alireza1405/medulla/documentation/images/medulla.1.5.JPG

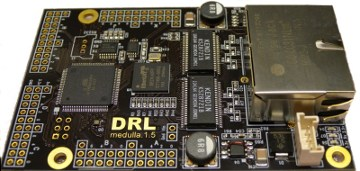
documentation/images/medulla.1.5.JPG
