alireza1405/medulla/hardware/medulla.1.5/CAM-2013/BOM.xls

Ref. Des. | Manufacture | Manufacture # | Description | Digikey # | Quantity
C1,2,3,4,5,6,7,8,9,10,11,12,19,20,21,22,23,24,25,26,27,28,29,30,31,32,35,36,37,38,39,40,41,42,43,44,45,46,47,48,49,50,53,54 | Murata Electronics North America | GRM188R71E104KA01D | CAP CER .1UF 25V 10% X7R | 490-1524-1-ND | 44
C13,14 | AVX Corporation | 0603ZD105KAT2A | CAP CERM 1UF 10% 10V X5R | 478-1251-1-ND | 2
C15,16,17,18 | TDK Corporation | C3225Y5V1E226Z | CAP CER 22UF 25V Y5V | 445-3478-1-ND | 4
C33,34 | Kemet | C0603C180J5GACTU | CAP CERAMIC 18PF 50V NP0 | 399-1052-1-ND | 2
D1 | Vishay/General Semiconductor | SSC53L-E3/57T | DIODE SCHOTTKY 5A 30V | SSC53L-E3/57TGICT-ND | 1
D4,5,6,7 | OSRAM Opto Semiconductors Inc | LG L29K-G2J1-24-Z | LED SMARTLED GREEN 570NM | 475-2709-1-ND | 4
D8,9 | OSRAM Opto Semiconductors Inc | LRTB R98G-R7T5-1+S7U-37+P7R-26 | LED MULTI RGB CHIPLED | 475-2855-1-ND | 2
L1,2 | TDK Corporation | VLP8040T-6R8M | INDUCTOR POWER 6.8UH 3.6A | 445-6586-1-ND | 2
L3,4,5,6,7 | TDK Corporation | MMZ1608R301A | FERRITE CHIP 300 OHM 500MA | 445-2171-1-ND | 5
Q1,2,3,4,5 | ON Semiconductor | NTA7002NT1G | MOSFET N-CH 30V 154MA | NTA7002NT1GOSCT-ND | 5
R1,6,7,8,10,22,23,24,25,26,27,28,29,30,31,32,33,34,35,36,37,38,39,40,41,42,43,44,45,47,48,49,50,51,52 | Rohm Semiconductor | MCR03EZPFX4701 | RES 4.70K OHM 1/10W 1% | RHM4.70KHCT-ND | 35
R12,13,14,15,16,17,18,19 | Rohm Semiconductor | MCR03EZPFX49R9 | RES 49.9 OHM 1/10W 1% | RHM49.9HCT-ND | 8
R2 | Rohm Semiconductor | MCR03EZPFX4020 | RES 402 OHM 1/10W 1% | RHM402HCT-ND | 1
R20,21 | Rohm Semiconductor | MCR03EZPFX64R9 | RES 64.9 OHM 1/10W 1% | RHM64.9HCT-ND | 2
R3,53 | Rohm Semiconductor | MCR03EZPFX8060 | RES 806 OHM 1/10W 1% | RHM806HCT-ND | 2
R4 | Rohm Semiconductor | MCR03EZPFX1651 | RES 1.65K OHM 1/10W 1% | RHM1.65KHCT-ND | 1
R46 | Rohm Semiconductor | MCR03EZPJ102 | RES 1.0K OHM 1/10W 5% | RHM1.0KGCT-ND | 1
R5 | Rohm Semiconductor | MCR03EZPFX1102 | RES 11.0K OHM 1/10W 1% | RHM11.0KHCT-ND | 1
R54,55 | Rohm Semiconductor | MCR03EZPJ430 | RES 43 OHM 1/10W 5% | RHM43GCT-ND | 2
R56 | Rohm Semiconductor | MCR03EZPJ750 | RES 75 OHM 1/10W 5% | RHM75GCT-ND | 1
R57 | Yageo | RC0603FR-0720KL | RES 20.0K OHM 1/10W 1% | 311-20.0KHRCT-ND | 1
R62 | Yageo | RC0603FR-0734KL | RES 34.0K OHM 1/10W 1% | 311-34.0KHRCT-ND | 1
R9,11,58,59,60,61 | Rohm Semiconductor | MCR03EZPFX6491 | RES 6.49K OHM 1/10W 1% | RHM6.49KHCT-ND | 6
S1,2 | C&K Components | KMR221GLFS | SWITCH TACT SPST-NO 200GF GW | 401-1427-1-ND | 2
U1 | Atmel | ATXMEGA128A1-AU | MCU AVR 128K FLASH | ATXMEGA128A1-AU-ND | 1
U2 | Texas Instruments | MAX3221CPWR | DRVR/RCVR RS-232 1-CH | 296-9594-1-ND | 1
U3,4 | Alpha & Omega Semiconductor Inc | AOZ1031AI | IC BUCK SYNC ADJ 3A | 785-1253-1-ND | 2
U5 | Microchip Technology | MCP1700T-2502E/TT | IC REG LDO 250MA 2.5V | MCP1700T-2502E/TTCT-ND | 1
U6,7 | Micrel Inc | KSZ8721B TR | TXRX PHY 10/100 2.5V | 576-1026-1-ND | 2
U8 | Beckhoff | ET1200 | EtherCAT ASIC |  | 1
U9 | Rohm Semiconductor | BR24S16FVT-WE2 | EEPROM 16KBIT 400KHZ | BR24S16FVT-WE2CT-ND | 1
Y1 | TXC Technology Inc | 7M-25.000MAAJ-T | CRYSTAL 25.000 MHZ 18PF | 887-1132-1-ND | 1
