alireza1405/medulla/hardware/medulla.1.5/Documents/BOM-medulla.1.5.ods

Sheet: Sheet BOMs
 | Net Cost | $93.76 | Total Part Count | 125
 | Estimated PCB Cost (50s) | $17.99
 | Estimated Placement Cost (50s) | $17.89
 | For 50 | $4,687.95
Ref. Des. | Manufacture | Manufacture # | Description | Quantity | Price (10sies) | Digikey # | Package | Subtotal | Comments | App. notes
uController
C1,2,3,4,5,6,7,8,9,10,11,12,20,21,22,25,53,54 | Murata Electronics North America | GRM188R71E104KA01D | CAP CER .1UF 25V 10% X7R | 18 | 0.019 | 490-1524-1-ND (http://search.digikey.com/scripts/dksearch/dksus.dll?Detail&name=490-1524-1-ND) | 0603 | 0.34 | Don't order, we have a reel on hand.
L3 | TDK Corporation | MMZ1608R301A | FERRITE CHIP 300 OHM 500MA | 1 | 0.053 | 445-2171-1-ND (http://search.digikey.com/scripts/DkSearch/dksus.dll?Detail&name=445-2171-1-ND) | 0603 | 0.05
 | Molex Connector Corporation | 35362-0350 | CONN HEADER 3POS 2MM VERT | 0 | 0.408 | WM18921-ND (http://search.digikey.com/scripts/dksearch/dksus.dll?Detail&name=WM18921-ND) |  | 0.00
U1 | Atmel | ATXMEGA128A1-AU | MCU AVR 128K FLASH | 1 | 10.200 | ATXMEGA128A1-AU-ND (http://search.digikey.com/scripts/DkSearch/dksus.dll?Detail&name=ATXMEGA128A1-AU-ND) | 100-TQFP | 10.20 | Price for onesies
C13,14 | AVX Corporation | 0603ZD105KAT2A | CAP CERM 1UF 10% 10V X5R | 2 | 0.061 | 478-1251-1-ND (http://search.digikey.com/scripts/DkSearch/dksus.dll?Detail&name=478-1251-1-ND) | 0603 | 0.12
C15,16,17,18 | TDK Corporation | C3225Y5V1E226Z | CAP CER 22UF 25V Y5V | 4 | 0.498 | 445-3478-1-ND (http://search.digikey.com/scripts/dksearch/dksus.dll?Detail&name=445-3478-1-ND) | 1210 | 1.99
D1 | Vishay/General Semiconductor | SSC53L-E3/57T | DIODE SCHOTTKY 5A 30V | 1 | 0.550 | SSC53L-E3/57TGICT-ND (http://search.digikey.com/scripts/dksearch/dksus.dll?Detail&name=SSC53L-E3/57TGICT-ND) | DO-214AB | 0.55
D4,6,7 | OSRAM Opto Semiconductors Inc | LG L29K-G2J1-24-Z | LED SMARTLED GREEN 570NM | 3 | 0.137 | 475-2709-1-ND (http://search.digikey.com/scripts/DkSearch/dksus.dll?Detail&name=475-2709-1-ND) | 0603 | 0.41
D8,9 | OSRAM Opto Semiconductors Inc | LRTB R98G-R7T5-1+S7U-37+P7R-26 | LED MULTI RGB CHIPLED | 2 | 0.860 | 475-2855-1-ND (http://search.digikey.com/scripts/DkSearch/dksus.dll?Detail&name=475-2855-1-ND) |  | 1.72
L1,2 | TDK Corporation | VLP8040T-6R8M | INDUCTOR POWER 6.8UH 3.6A | 2 | 0.524 | 445-6586-1-ND (http://search.digikey.com/scripts/DkSearch/dksus.dll?Detail&name=445-6586-1-ND) |  | 1.05
 | Molex Connector Corporation | 35362-0450 | CONN HEADER 4POS 2MM VERT | 0 | 0.470 | WM18922-ND (http://search.digikey.com/scripts/dksearch/dksus.dll?Detail&name=WM18922-ND) |  | 0.00
Q1,2,3,4,5 | ON Semiconductor | NTA7002NT1G | MOSFET N-CH 30V 154MA | 5 | 0.300 | NTA7002NT1GOSCT-ND (http://search.digikey.com/scripts/dksearch/dksus.dll?Detail&name=NTA7002NT1GOSCT-ND) | SC-75-3 | 1.50
R54,55 | Rohm Semiconductor | MCR03EZPJ430 | RES 43 OHM 1/10W 5% | 2 | 0.018 | RHM43GCT-ND (http://search.digikey.com/scripts/DkSearch/dksus.dll?Detail&name=RHM43GCT-ND) | 0603 | 0.04
R56 | Rohm Semiconductor | MCR03EZPJ750 | RES 75 OHM 1/10W 5% | 1 | 0.018 | RHM75GCT-ND (http://search.digikey.com/scripts/DkSearch/dksus.dll?Detail&name=RHM75GCT-ND) | 0603 | 0.02
R2 | Rohm Semiconductor | MCR03EZPFX4020 | RES 402 OHM 1/10W 1% | 1 | 0.023 | RHM402HCT-ND (http://search.digikey.com/scripts/DkSearch/dksus.dll?Detail&name=RHM402HCT-ND) | 0603 | 0.02
R3 | Rohm Semiconductor | MCR03EZPFX8060 | RES 806 OHM 1/10W 1% | 1 | 0.023 | RHM806HCT-ND (http://search.digikey.com/scripts/DkSearch/dksus.dll?Detail&name=RHM806HCT-ND) | 0603 | 0.02
R4 | Rohm Semiconductor | MCR03EZPFX1651 | RES 1.65K OHM 1/10W 1% | 1 | 0.023 | RHM1.65KHCT-ND (http://search.digikey.com/scripts/DkSearch/dksus.dll?Detail&name=RHM1.65KHCT-ND) | 0603 | 0.02
R1 | Rohm Semiconductor | MCR03EZPFX4701 | RES 4.70K OHM 1/10W 1% | 1 | 0.023 | RHM4.70KHCT-ND (http://search.digikey.com/scripts/DkSearch/dksus.dll?Detail&name=RHM4.70KHCT-ND) | 0603 | 0.02
R58,59,60,61 | Rohm Semiconductor | MCR03EZPFX6491 | RES 6.49K OHM 1/10W 1% | 4 | 0.023 | RHM6.49KHCT-ND (http://search.digikey.com/scripts/DkSearch/dksus.dll?Detail&name=RHM6.49KHCT-ND) | 0603 | 0.09
R57 | Yageo | RC0603FR-0720KL | RES 20.0K OHM 1/10W 1% | 1 | 0.014 | 311-20.0KHRCT-ND (http://search.digikey.com/scripts/DkSearch/dksus.dll?Detail&name=311-20.0KHRCT-ND) | 0603 | 0.01
R62 | Yageo | RC0603FR-0734KL | RES 34.0K OHM 1/10W 1% | 1 | 0.014 | 311-34.0KHRCT-ND (http://search.digikey.com/scripts/DkSearch/dksus.dll?Detail&name=311-34.0KHRCT-ND) | 0603 | 0.01
S1,2 | C&K Components | KMR221GLFS | SWITCH TACT SPST-NO 200GF GW | 2 | 0.370 | 401-1427-1-ND (http://search.digikey.com/scripts/dksearch/dksus.dll?Detail&name=401-1427-1-ND) |  | 0.74
U3,4 | Alpha & Omega Semiconductor Inc | AOZ1031AI | IC BUCK SYNC ADJ 3A | 2 | 1.400 | 785-1253-1-ND (http://search.digikey.com/scripts/DkSearch/dksus.dll?Detail&name=785-1253-1-ND) | SO-8 | 2.80 | Price for onesies
U2 | Texas Instruments | MAX3221CPWR | DRVR/RCVR RS-232 1-CH | 1 | 1.930 | 296-9594-1-ND (http://search.digikey.com/scripts/DkSearch/dksus.dll?Detail&name=296-9594-1-ND) | 16-TSSOP | 1.93 | Price for onesies
U5 | Microchip Technology | MCP1700T-2502E/TT | IC REG LDO 250MA 2.5V | 1 | 0.370 | MCP1700T-2502E/TTCT-ND (http://search.digikey.com/scripts/DkSearch/dksus.dll?Detail&name=MCP1700T-2502E/TTCT-ND) | SOT23-3 | 0.37
Subtotal |  |  |  | 38 |  |  |  | 24.04
EtherCAT
C33,34 | Kemet | C0603C180J5GACTU | CAP CERAMIC 18PF 50V NP0 | 2 | 0.031 | 399-1052-1-ND (http://search.digikey.com/scripts/dksearch/dksus.dll?Detail&name=399-1052-1-ND) | 0603 | 0.06
C19,23,24,26,27,28,29,30,31,32,35,36,37,38,39,40,41,42,43,44,45,46,47,48,49,50 | Murata Electronics North America | GRM188R71E104KA01D | CAP CER .1UF 25V 10% X7R | 26 | 0.019 | 490-1524-1-ND (http://search.digikey.com/scripts/dksearch/dksus.dll?Detail&name=490-1524-1-ND) | 0603 | 0.49 | Don't order, we have a reel on hand.
D5 | OSRAM Opto Semiconductors Inc | LG L29K-G2J1-24-Z | LED SMARTLED GREEN 570NM | 1 | 0.137 | 475-2709-1-ND (http://search.digikey.com/scripts/DkSearch/dksus.dll?Detail&name=475-2709-1-ND) | 0603 | 0.14
 | Pulse | JG0-0031NL | CONN PULSEJACK 2PORT POETHERNET | 0 | 13.006 | 553-1361-ND (http://search.digikey.com/scripts/DkSearch/dksus.dll?Detail&name=553-1361-ND) |  | 0.00
L4,5,6,7 | TDK Corporation | MMZ1608R301A | FERRITE CHIP 300 OHM 500MA | 4 | 0.053 | 445-2171-1-ND (http://search.digikey.com/scripts/DkSearch/dksus.dll?Detail&name=445-2171-1-ND) | 0603 | 0.21
R12,13,14,15,16,17,18,19 | Rohm Semiconductor | MCR03EZPFX49R9 | RES 49.9 OHM 1/10W 1% | 8 | 0.023 | RHM49.9HCT-ND (http://search.digikey.com/scripts/DkSearch/dksus.dll?Detail&name=RHM49.9HCT-ND) | 0603 | 0.18
R20,21 | Rohm Semiconductor | MCR03EZPFX64R9 | RES 64.9 OHM 1/10W 1% | 2 | 0.023 | RHM64.9HCT-ND (http://search.digikey.com/scripts/DkSearch/dksus.dll?Detail&name=RHM64.9HCT-ND) | 0603 | 0.05
R53 | Rohm Semiconductor | MCR03EZPFX8060 | RES 806 OHM 1/10W 1% | 1 | 0.023 | RHM806HCT-ND (http://search.digikey.com/scripts/DkSearch/dksus.dll?Detail&name=RHM806HCT-ND) | 0603 | 0.02
R46 | Rohm Semiconductor | MCR03EZPJ102 | RES 1.0K OHM 1/10W 5% | 1 | 0.018 | RHM1.0KGCT-ND (http://search.digikey.com/scripts/DkSearch/dksus.dll?Detail&name=RHM1.0KGCT-ND) | 0603 | 0.02
R6,7,8,10,22,23,24,25,26,27,28,29,30,31,32,33,34,35,36,37,38,39,40,41,42,43,44,45,47,48,49,50,51,52 | Rohm Semiconductor | MCR03EZPFX4701 | RES 4.70K OHM 1/10W 1% | 34 | 0.023 | RHM4.70KHCT-ND (http://search.digikey.com/scripts/DkSearch/dksus.dll?Detail&name=RHM4.70KHCT-ND) | 0603 | 0.78
R9,11 | Rohm Semiconductor | MCR03EZPFX6491 | RES 6.49K OHM 1/10W 1% | 2 | 0.023 | RHM6.49KHCT-ND (http://search.digikey.com/scripts/DkSearch/dksus.dll?Detail&name=RHM6.49KHCT-ND) | 0603 | 0.05
R5 | Rohm Semiconductor | MCR03EZPFX1102 | RES 11.0K OHM 1/10W 1% | 1 | 0.023 | RHM11.0KHCT-ND (http://search.digikey.com/scripts/DkSearch/dksus.dll?Detail&name=RHM11.0KHCT-ND) | 0603 | 0.02
U8 | Beckhoff | ET1200 | EtherCAT ASIC | 1 | 21.000 |  | BGA | 21.00 | Special order from Beckhoff, price is an estimate
U6,7 | Micrel Inc | KSZ8721B TR | TXRX PHY 10/100 2.5V | 2 | 4.320 | 576-1026-1-ND (http://search.digikey.com/scripts/dksearch/dksus.dll?Detail&name=576-1026-1-ND) | 48SSOP | 8.64 | Price for onesies
U9 | Rohm Semiconductor | BR24S16FVT-WE2 | EEPROM 16KBIT 400KHZ | 1 | 1.03 | BR24S16FVT-WE2CT-ND (http://search.digikey.com/scripts/dksearch/dksus.dll?Detail&name=BR24S16FVT-WE2CT-ND) | 8-TSSOP-B | 1.03 | Price for onesies
Y1 | TXC Technology Inc | 7M-25.000MAAJ-T | CRYSTAL 25.000 MHZ 18PF | 1 | 1.138 | 887-1132-1-ND (http://search.digikey.com/scripts/DkSearch/dksus.dll?Detail&name=887-1132-1-ND) | 3.2mm x 2.5mm | 1.14
Subtotal |  |  |  | 87 |  |  |  | 33.84

Sheet: Full BOM
Ref. Des. | Manufacture | Manufacture # | Description | Digikey # | Quantity | x50 | # Ordered
C1,2,3,4,5,6,7,8,9,10,11,12,19,20,21,22,23,24,25,26,27,28,29,30,31,32,35,36,37,38,39,40,41,42,43,44,45,46,47,48,49,50,53,54 | Murata Electronics North America | GRM188R71E104KA01D | CAP CER .1UF 25V 10% X7R | 490-1524-1-ND | 44 | 2200
C13,14 | AVX Corporation | 0603ZD105KAT2A | CAP CERM 1UF 10% 10V X5R | 478-1251-1-ND | 2 | 100 | 150
C15,16,17,18 | TDK Corporation | C3225Y5V1E226Z | CAP CER 22UF 25V Y5V | 445-3478-1-ND | 4 | 200 | 250
C33,34 | Kemet | C0603C180J5GACTU | CAP CERAMIC 18PF 50V NP0 | 399-1052-1-ND | 2 | 100 | 150
D1 | Vishay/General Semiconductor | SSC53L-E3/57T | DIODE SCHOTTKY 5A 30V | SSC53L-E3/57TGICT-ND | 1 | 50 | 55
D4,5,6,7 | OSRAM Opto Semiconductors Inc | LG L29K-G2J1-24-Z | LED SMARTLED GREEN 570NM | 475-2709-1-ND | 4 | 200 | 250
D8,9 | OSRAM Opto Semiconductors Inc | LRTB R98G-R7T5-1+S7U-37+P7R-26 | LED MULTI RGB CHIPLED | 475-2855-1-ND | 2 | 100 | 110
L1,2 | TDK Corporation | VLP8040T-6R8M | INDUCTOR POWER 6.8UH 3.6A | 445-6586-1-ND | 2 | 100 | 110
L3,4,5,6,7 | TDK Corporation | MMZ1608R301A | FERRITE CHIP 300 OHM 500MA | 445-2171-1-ND | 5 | 250 | 300
Q1,2,3,4,5 | ON Semiconductor | NTA7002NT1G | MOSFET N-CH 30V 154MA | NTA7002NT1GOSCT-ND | 5 | 250 | 275
R1,6,7,8,10,22,23,24,25,26,27,28,29,30,31,32,33,34,35,36,37,38,39,40,41,42,43,44,45,47,48,49,50,51,52 | Rohm Semiconductor | MCR03EZPFX4701 | RES 4.70K OHM 1/10W 1% | RHM4.70KHCT-ND | 35 | 1750 | 2000
R12,13,14,15,16,17,18,19 | Rohm Semiconductor | MCR03EZPFX49R9 | RES 49.9 OHM 1/10W 1% | RHM49.9HCT-ND | 8 | 400 | 500
R2 | Rohm Semiconductor | MCR03EZPFX4020 | RES 402 OHM 1/10W 1% | RHM402HCT-ND | 1 | 50 | 60
R20,21 | Rohm Semiconductor | MCR03EZPFX64R9 | RES 64.9 OHM 1/10W 1% | RHM64.9HCT-ND | 2 | 100 | 120
R3,53 | Rohm Semiconductor | MCR03EZPFX8060 | RES 806 OHM 1/10W 1% | RHM806HCT-ND | 2 | 100 | 120
R4 | Rohm Semiconductor | MCR03EZPFX1651 | RES 1.65K OHM 1/10W 1% | RHM1.65KHCT-ND | 1 | 50 | 60
R46 | Rohm Semiconductor | MCR03EZPJ102 | RES 1.0K OHM 1/10W 5% | RHM1.0KGCT-ND | 1 | 50 | 60
R5 | Rohm Semiconductor | MCR03EZPFX1102 | RES 11.0K OHM 1/10W 1% | RHM11.0KHCT-ND | 1 | 50 | 60
R54,55 | Rohm Semiconductor | MCR03EZPJ430 | RES 43 OHM 1/10W 5% | RHM43GCT-ND | 2 | 100 | 120
R56 | Rohm Semiconductor | MCR03EZPJ750 | RES 75 OHM 1/10W 5% | RHM75GCT-ND | 1 | 50 | 60
R57 | Yageo | RC0603FR-0720KL | RES 20.0K OHM 1/10W 1% | 311-20.0KHRCT-ND | 1 | 50 | 60
R62 | Yageo | RC0603FR-0734KL | RES 34.0K OHM 1/10W 1% | 311-34.0KHRCT-ND | 1 | 50 | 60
R9,11,58,59,60,61 | Rohm Semiconductor | MCR03EZPFX6491 | RES 6.49K OHM 1/10W 1% | RHM6.49KHCT-ND | 6 | 300 | 400
S1,2 | C&K Components | KMR221GLFS | SWITCH TACT SPST-NO 200GF GW | 401-1427-1-ND | 2 | 100 | 110
U1 | Atmel | ATXMEGA128A1-AU | MCU AVR 128K FLASH | ATXMEGA128A1-AU-ND | 1 | 50 | 55
U2 | Texas Instruments | MAX3221CPWR | DRVR/RCVR RS-232 1-CH | 296-9594-1-ND | 1 | 50 | 55
U3,4 | Alpha & Omega Semiconductor Inc | AOZ1031AI | IC BUCK SYNC ADJ 3A | 785-1253-1-ND | 2 | 100 | 110
U5 | Microchip Technology | MCP1700T-2502E/TT | IC REG LDO 250MA 2.5V | MCP1700T-2502E/TTCT-ND | 1 | 50 | 55
U6,7 | Micrel Inc | KSZ8721B TR | TXRX PHY 10/100 2.5V | 576-1026-1-ND | 2 | 100 | 110
U8 | Beckhoff | ET1200 | EtherCAT ASIC |  | 1 | 50
U9 | Rohm Semiconductor | BR24S16FVT-WE2 | EEPROM 16KBIT 400KHZ | BR24S16FVT-WE2CT-ND | 1 | 50 | 55
Y1 | TXC Technology Inc | 7M-25.000MAAJ-T | CRYSTAL 25.000 MHZ 18PF | 887-1132-1-ND | 1 | 50 | 55
