alireza1405/medulla/hardware/medulla.1/Documents/BOM-medulla.1.ods

 | Net Cost | $133.83 | Total Part Count | 113
 | Estimated PCB Cost | 66
 | (In sammaches) | 26.77
Ref. Des. | Manufacture | Manufacture # | Description | Quantity | Price (10sies) | Digikey # | Package | Subtotal | Donation or Sample | Comments | App. notes
uController
C1,2,3,4,5,6,7,8,9,10,11,12,14,20,21,22,25 | Murata Electronics North America | GRM188R71E104KA01D | CAP CER .1UF 25V 10% X7R | 17 | 0.019 | 490-1524-1-ND (http://search.digikey.com/scripts/dksearch/dksus.dll?Detail&name=490-1524-1-ND) | 0603 | 0.32
L3 | TDK Corporation | MMZ1608R301A | FERRITE CHIP 300 OHM 500MA | 1 | 0.053 | 445-2171-1-ND (http://search.digikey.com/scripts/DkSearch/dksus.dll?Detail&name=445-2171-1-ND) | 0603 | 0.05
J3 | Molex Connector Corporation | 35362-0350 | CONN HEADER 3POS 2MM VERT | 1 | 0.408 | WM18921-ND (http://search.digikey.com/scripts/dksearch/dksus.dll?Detail&name=WM18921-ND) |  | 0.41
U1 | Atmel | ATXMEGA128A1-AU | MCU AVR 128K FLASH | 1 | 10.200 | ATXMEGA128A1-AU-ND (http://search.digikey.com/scripts/DkSearch/dksus.dll?Detail&name=ATXMEGA128A1-AU-ND) | 100-TQFP | 10.20 |  | Price for onesies
C13 | Kemet | C0603C225K9PACTU | CAP CERAMIC 2.2UF 6.3V X5R | 1 | 0.121 | 399-3362-1-ND (http://search.digikey.com/scripts/dksearch/dksus.dll?Detail&name=399-3362-1-ND) | 0603 | 0.12
C15,16,17,18 | Murata Electronics North America | GRM21BR61E106KA73L | CAP CER 10UF 25V X5R | 4 | 0.583 | 490-5523-1-ND (http://search.digikey.com/scripts/dksearch/dksus.dll?Detail&name=490-5523-1-ND) | 0805 | 2.33
D1 | Vishay/General Semiconductor | SSC53L-E3/57T | DIODE SCHOTTKY 5A 30V | 1 | 0.550 | SSC53L-E3/57TGICT-ND (http://search.digikey.com/scripts/dksearch/dksus.dll?Detail&name=SSC53L-E3/57TGICT-ND) | DO-214AB | 0.55
D2,3 | Diodes Inc | DFLS230-7 | DIODE SCHOTTKY 2A 30V | 2 | 0.646 | DFLS230DICT-ND (http://search.digikey.com/scripts/dksearch/dksus.dll?Detail&name=DFLS230DICT-ND) | PowerDI™ 123 | 1.29
D4,6,7 | OSRAM Opto Semiconductors Inc | LG L29K-G2J1-24-Z | LED SMARTLED GREEN 570NM | 3 | 0.137 | 475-2709-1-ND (http://search.digikey.com/scripts/DkSearch/dksus.dll?Detail&name=475-2709-1-ND) | 0603 | 0.41
L1,2 | Taiyo Yuden | NR10050T470M | INDUCTOR 47UH 2A 20% | 2 | 1.100 | 587-1700-1-ND (http://search.digikey.com/scripts/dksearch/dksus.dll?Detail&name=587-1700-1-ND) | 10.00mm x 9.80mm x 5.00mm | 2.20
J1 | Molex Connector Corporation | 35362-0450 | CONN HEADER 4POS 2MM VERT | 1 | 0.470 | WM18922-ND (http://search.digikey.com/scripts/dksearch/dksus.dll?Detail&name=WM18922-ND) |  | 0.47
Q1,2 | ON Semiconductor | NTA7002NT1G | MOSFET N-CH 30V 154MA | 2 | 0.270 | NTA7002NT1GOSCT-ND (http://search.digikey.com/scripts/dksearch/dksus.dll?Detail&name=NTA7002NT1GOSCT-ND) | SC-75-3 | 0.54
R2 | Rohm Semiconductor | MCR03EZPFX4020 | RES 402 OHM 1/10W 1% | 1 | 0.077 | RHM402HCT-ND (http://search.digikey.com/scripts/DkSearch/dksus.dll?Detail&name=RHM402HCT-ND) | 0603 | 0.08
R3 | Rohm Semiconductor | MCR03EZPFX8060 | RES 806 OHM 1/10W 1% | 1 | 0.077 | RHM806HCT-ND (http://search.digikey.com/scripts/DkSearch/dksus.dll?Detail&name=RHM806HCT-ND) | 0603 | 0.08
R4 | Rohm Semiconductor | MCR03EZPFX1651 | RES 1.65K OHM 1/10W 1% | 1 | 0.077 | RHM1.65KHCT-ND (http://search.digikey.com/scripts/DkSearch/dksus.dll?Detail&name=RHM1.65KHCT-ND) | 0603 | 0.08
R1 | Rohm Semiconductor | MCR03EZPFX4701 | RES 4.70K OHM 1/10W 1% | 1 | 0.077 | RHM4.70KHCT-ND (http://search.digikey.com/scripts/DkSearch/dksus.dll?Detail&name=RHM4.70KHCT-ND) | 0603 | 0.08
S1 | C&K Components | KMR221GLFS | SWITCH TACT SPST-NO 200GF GW | 1 | 0.370 | 401-1427-1-ND (http://search.digikey.com/scripts/dksearch/dksus.dll?Detail&name=401-1427-1-ND) |  | 0.37
U3 | Diodes Inc | AP1509-50SG-13 | CONV DC-DC 2A 5.0V | 1 | 2.170 | AP1509-50SGDICT-ND (http://search.digikey.com/scripts/dksearch/dksus.dll?Detail&name=AP1509-50SGDICT-ND) | 8-SOIC | 2.17 |  | Price for onesies
U4 | Diodes Inc | AP1509-33SG-13 | CONV DC-DC 2A 3.3V | 1 | 2.170 | AP1509-33SGDICT-ND (http://search.digikey.com/scripts/dksearch/dksus.dll?Detail&name=AP1509-33SGDICT-ND) | 8-SOIC | 2.17 |  | Price for onesies
U2 | Texas Instruments | MAX3221CPWR | DRVR/RCVR RS-232 1-CH | 1 | 1.930 | 296-9594-1-ND (http://search.digikey.com/scripts/DkSearch/dksus.dll?Detail&name=296-9594-1-ND) | 16-TSSOP | 1.93 |  | Price for onesies
U5 | STMicroelectronics | KF25BD-TR | REG VLDO 2.5V INHIB | 1 | 1.479 | 497-7756-1-ND (http://search.digikey.com/scripts/dksearch/dksus.dll?Detail&name=497-7756-1-ND) | 8-SOIC | 1.48 |  | Price for onesies
Subtotal |  |  |  | 25 |  |  |  | 27.33
EtherCAT
C33,34 | Kemet | C0603C180J5GACTU | CAP CERAMIC 18PF 50V NP0 | 2 | 0.031 | 399-1052-1-ND (http://search.digikey.com/scripts/dksearch/dksus.dll?Detail&name=399-1052-1-ND) | 0603 | 0.06
C19,23,24,26,27,28,29,30,31,32,35,36,37,38,39,40,41,42,43,44,45,46,47,48,49,50 | Murata Electronics North America | GRM188R71E104KA01D | CAP CER .1UF 25V 10% X7R | 26 | 0.019 | 490-1524-1-ND (http://search.digikey.com/scripts/dksearch/dksus.dll?Detail&name=490-1524-1-ND) | 0603 | 0.49
D5 | OSRAM Opto Semiconductors Inc | LG L29K-G2J1-24-Z | LED SMARTLED GREEN 570NM | 1 | 0.137 | 475-2709-1-ND (http://search.digikey.com/scripts/DkSearch/dksus.dll?Detail&name=475-2709-1-ND) | 0603 | 0.14
J2 | Pulse | JG0-0031NL | CONN PULSEJACK 2PORT POETHERNET | 1 | 15.110 | 553-1361-ND (http://search.digikey.com/scripts/DkSearch/dksus.dll?Detail&name=553-1361-ND) |  | 15.11 |  | Price for onesies
L4,5,6,7 | TDK Corporation | MMZ1608R301A | FERRITE CHIP 300 OHM 500MA | 4 | 0.053 | 445-2171-1-ND (http://search.digikey.com/scripts/DkSearch/dksus.dll?Detail&name=445-2171-1-ND) | 0603 | 0.21
R12,13,14,15,16,17,18,19 | Rohm Semiconductor | MCR03EZPFX49R9 | RES 49.9 OHM 1/10W 1% | 8 | 0.077 | RHM49.9HCT-ND (http://search.digikey.com/scripts/DkSearch/dksus.dll?Detail&name=RHM49.9HCT-ND) | 0603 | 0.62
R20,21 | Rohm Semiconductor | MCR03EZPFX64R9 | RES 64.9 OHM 1/10W 1% | 2 | 0.077 | RHM64.9HCT-ND (http://search.digikey.com/scripts/DkSearch/dksus.dll?Detail&name=RHM64.9HCT-ND) | 0603 | 0.15
R53 | Rohm Semiconductor | MCR03EZPFX8060 | RES 806 OHM 1/10W 1% | 1 | 0.077 | RHM806HCT-ND (http://search.digikey.com/scripts/DkSearch/dksus.dll?Detail&name=RHM806HCT-ND) | 0603 | 0.08
R6,7,8,10,22,23,24,25,26,27,28,29,30,31,32,33,34,35,36,37,38,39,40,41,42,43,44,45,46,47,48,49,50,51,52 | Rohm Semiconductor | MCR03EZPFX4701 | RES 4.70K OHM 1/10W 1% | 35 | 0.077 | RHM4.70KHCT-ND (http://search.digikey.com/scripts/DkSearch/dksus.dll?Detail&name=RHM4.70KHCT-ND) | 0603 | 2.70
R9,11 | Rohm Semiconductor | MCR03EZPFX6491 | RES 6.49K OHM 1/10W 1% | 2 | 0.077 | RHM6.49KHCT-ND (http://search.digikey.com/scripts/DkSearch/dksus.dll?Detail&name=RHM6.49KHCT-ND) | 0603 | 0.15
R5 | Rohm Semiconductor | MCR03EZPFX1102 | RES 11.0K OHM 1/10W 1% | 1 | 0.077 | RHM11.0KHCT-ND (http://search.digikey.com/scripts/DkSearch/dksus.dll?Detail&name=RHM11.0KHCT-ND) | 0603 | 0.08
U8 | Beckhoff | ET1200 | EtherCAT ASIC | 1 | 10.000 |  |  | 10.00 |  | Special order from Beckhoff, price is an estimate
U6,7 | Micrel Inc | KSZ8721B TR | TXRX PHY 10/100 2.5V | 2 | 4.320 | 576-1026-1-ND (http://search.digikey.com/scripts/dksearch/dksus.dll?Detail&name=576-1026-1-ND) | 48SSOP | 8.64 |  | Price for onesies
U9 | Rohm Semiconductor | BR24S16FVT-WE2 | EEPROM 16KBIT 400KHZ | 1 | 0.940 | BR24S16FVT-WE2CT-ND (http://search.digikey.com/scripts/dksearch/dksus.dll?Detail&name=BR24S16FVT-WE2CT-ND) | 8-TSSOP-B | 0.94 |  | Price for onesies
Y1 | TXC Technology Inc | 7M-25.000MAAJ-T | CRYSTAL 25.000 MHZ 18PF | 1 | 1.138 | 887-1132-1-ND (http://search.digikey.com/scripts/DkSearch/dksus.dll?Detail&name=887-1132-1-ND) | 3.2mm x 2.5mm | 1.14
Subtotal |  |  |  | 88 |  |  |  | 40.51
