alireza1405/medulla/hardware/medulla.0/Documents/BOM-medulla.0.ods

Sheet: Sheet BOMs
 | Net Cost | $225.66 | Total Part Count | 226
 | Estimated PCB Cost | 66
 | (In sammaches) | 45.13
Ref. Des. | Manufacture | Manufacture # | Description | Quantity | Price (10sies) | Digikey # | Package | Subtotal | Donation or Sample | Comments | App. notes
uController
C1,2,3,4,10,11,12,13,25,34,35,36 | Murata Electronics North America | GRM188R71E104KA01D | CAP CER .1UF 25V 10% X7R | 12 | 0.019 | 490-1524-1-ND (http://search.digikey.com/scripts/dksearch/dksus.dll?Detail&name=490-1524-1-ND) | 0603 | 0.23
L1,2 | TDK Corporation | MMZ1608R301A | FERRITE CHIP 300 OHM 500MA | 2 | 0.053 | 445-2171-1-ND (http://search.digikey.com/scripts/DkSearch/dksus.dll?Detail&name=445-2171-1-ND) | 0603 | 0.11
U1,21 | Atmel | ATXMEGA128A3-AU | MCU AVR 128K FLASH | 2 | 8.060 | ATXMEGA128A3-AU-ND (http://search.digikey.com/scripts/dksearch/dksus.dll?Detail&name=ATXMEGA128A3-AU-ND) | 64-TQFP | 16.12 |  | Price for onesies
Subtotal |  |  |  | 16 |  |  |  | 16.45
EtherCAT
C52,80 | Kemet | C0603C180J5GACTU | CAP CERAMIC 18PF 50V NP0 | 2 | 0.031 | 399-1052-1-ND (http://search.digikey.com/scripts/dksearch/dksus.dll?Detail&name=399-1052-1-ND) | 0603 | 0.06
C37,39,40,45,46,47,48,49,50,51,53,54,55,56,57,58,59,60,61,62,63,66,67,68,73,82 | Murata Electronics North America | GRM188R71E104KA01D | CAP CER .1UF 25V 10% X7R | 26 | 0.019 | 490-1524-1-ND (http://search.digikey.com/scripts/dksearch/dksus.dll?Detail&name=490-1524-1-ND) | 0603 | 0.49
D5 | OSRAM Opto Semiconductors Inc | LG L29K-G2J1-24-Z | LED SMARTLED GREEN 570NM | 1 | 0.137 | 475-2709-1-ND (http://search.digikey.com/scripts/DkSearch/dksus.dll?Detail&name=475-2709-1-ND) | 0603 | 0.14
J2 | Pulse | JG0-0031NL | CONN PULSEJACK 2PORT POETHERNET | 1 | 13.150 | 553-1361-ND (http://search.digikey.com/scripts/DkSearch/dksus.dll?Detail&name=553-1361-ND) |  | 13.15 |  | Price for onesies
L5,6,7,8 | TDK Corporation | MMZ1608R301A | FERRITE CHIP 300 OHM 500MA | 4 | 0.053 | 445-2171-1-ND (http://search.digikey.com/scripts/DkSearch/dksus.dll?Detail&name=445-2171-1-ND) | 0603 | 0.21
R66,67,68,69,82,83,84,85 | Rohm Semiconductor | MCR03EZPFX49R9 | RES 49.9 OHM 1/10W 1% | 8 | 0.077 | RHM49.9HCT-ND (http://search.digikey.com/scripts/DkSearch/dksus.dll?Detail&name=RHM49.9HCT-ND) | 0603 | 0.62
R70,71 | Rohm Semiconductor | MCR03EZPFX64R9 | RES 64.9 OHM 1/10W 1% | 2 | 0.077 | RHM64.9HCT-ND (http://search.digikey.com/scripts/DkSearch/dksus.dll?Detail&name=RHM64.9HCT-ND) | 0603 | 0.15
R75 | Rohm Semiconductor | MCR03EZPFX8060 | RES 806 OHM 1/10W 1% | 1 | 0.077 | RHM806HCT-ND (http://search.digikey.com/scripts/DkSearch/dksus.dll?Detail&name=RHM806HCT-ND) | 0603 | 0.08
R37,38,39,40,41,42,43,44,45,46,48,49,50,51,52,53,54,55,56,57,58,59,60,61,62,63,64,65,72,73,74,76,77,80,81 | Rohm Semiconductor | MCR03EZPFX4701 | RES 4.70K OHM 1/10W 1% | 35 | 0.077 | RHM4.70KHCT-ND (http://search.digikey.com/scripts/DkSearch/dksus.dll?Detail&name=RHM4.70KHCT-ND) | 0603 | 2.70
R36,47 | Rohm Semiconductor | MCR03EZPFX6491 | RES 6.49K OHM 1/10W 1% | 2 | 0.077 | RHM6.49KHCT-ND (http://search.digikey.com/scripts/DkSearch/dksus.dll?Detail&name=RHM6.49KHCT-ND) | 0603 | 0.15
R78 | Rohm Semiconductor | MCR03EZPFX1102 | RES 11.0K OHM 1/10W 1% | 1 | 0.077 | RHM11.0KHCT-ND (http://search.digikey.com/scripts/DkSearch/dksus.dll?Detail&name=RHM11.0KHCT-ND) | 0603 | 0.08
U28 | Beckhoff | ET1200 | EtherCAT ASIC | 1 | 10.000 |  |  | 10.00 |  | Special order from Beckhoff, price is an estimate
U19,20 | Micrel Inc | KSZ8721B TR | TXRX PHY 10/100 2.5V | 2 | 4.320 | 576-1026-1-ND (http://search.digikey.com/scripts/dksearch/dksus.dll?Detail&name=576-1026-1-ND) | 48SSOP | 8.64 |  | Price for onesies
U27 | Rohm Semiconductor | BR24S16FVT-WE2 | EEPROM 16KBIT 400KHZ | 1 | 0.940 | BR24S16FVT-WE2CT-ND (http://search.digikey.com/scripts/dksearch/dksus.dll?Detail&name=BR24S16FVT-WE2CT-ND) | 8-TSSOP-B | 0.94 |  | Price for onesies
Y2 | TXC Technology Inc | 7M-25.000MAAJ-T | CRYSTAL 25.000 MHZ 18PF | 1 | 1.138 | 887-1132-1-ND (http://search.digikey.com/scripts/DkSearch/dksus.dll?Detail&name=887-1132-1-ND) | 3.2mm x 2.5mm | 1.14
Subtotal |  |  |  | 88 |  |  |  | 38.55
Power/Reset
C65,84 | Murata Electronics North America | GRM188R71E104KA01D | CAP CER .1UF 25V 10% X7R | 2 | 0.019 | 490-1524-1-ND (http://search.digikey.com/scripts/dksearch/dksus.dll?Detail&name=490-1524-1-ND) | 0603 | 0.04
C64 | Kemet | C0603C225K9PACTU | CAP CERAMIC 2.2UF 6.3V X5R | 1 | 0.121 | 399-3362-1-ND (http://search.digikey.com/scripts/dksearch/dksus.dll?Detail&name=399-3362-1-ND) | 0603 | 0.12
C41,42,43,44 | Taiyo Yuden | TMK316BJ106KL-T | CAP CER 10UF 25V X5R | 4 | 0.583 | 587-1337-1-ND (http://search.digikey.com/scripts/dksearch/dksus.dll?Detail&name=587-1337-1-ND) | 1206 | 2.33
D1,2,7 | Vishay/General Semiconductor | SSC53L-E3/57T | DIODE SCHOTTKY 5A 30V | 3 | 0.550 | SSC53L-E3/57TGICT-ND (http://search.digikey.com/scripts/dksearch/dksus.dll?Detail&name=SSC53L-E3/57TGICT-ND) | DO-214AB | 1.65
D3,4,6 | OSRAM Opto Semiconductors Inc | LG L29K-G2J1-24-Z | LED SMARTLED GREEN 570NM | 3 | 0.137 | 475-2709-1-ND (http://search.digikey.com/scripts/DkSearch/dksus.dll?Detail&name=475-2709-1-ND) | 0603 | 0.41
L3,4 | Taiyo Yuden | NR10050T470M | INDUCTOR 47UH 2A 20% | 2 | 1.100 | 587-1700-1-ND (http://search.digikey.com/scripts/dksearch/dksus.dll?Detail&name=587-1700-1-ND) | 10.00mm x 9.80mm x 5.00mm | 2.20
J80 | Molex Connector Corporation | 35362-0450 | CONN HEADER 4POS 2MM VERT | 1 | 0.470 | WM18922-ND (http://search.digikey.com/scripts/dksearch/dksus.dll?Detail&name=WM18922-ND) |  | 0.47
Q13,14,15 | ON Semiconductor | NTA7002NT1G | MOSFET N-CH 30V 154MA | 3 | 0.270 | NTA7002NT1GOSCT-ND (http://search.digikey.com/scripts/dksearch/dksus.dll?Detail&name=NTA7002NT1GOSCT-ND) | SC-75-3 | 0.81
R79 | Rohm Semiconductor | MCR03EZPFX4020 | RES 402 OHM 1/10W 1% | 1 | 0.077 | RHM402HCT-ND (http://search.digikey.com/scripts/DkSearch/dksus.dll?Detail&name=RHM402HCT-ND) | 0603 | 0.08
R1 | Rohm Semiconductor | MCR03EZPFX8060 | RES 806 OHM 1/10W 1% | 1 | 0.077 | RHM806HCT-ND (http://search.digikey.com/scripts/DkSearch/dksus.dll?Detail&name=RHM806HCT-ND) | 0603 | 0.08
R2 | Rohm Semiconductor | MCR03EZPFX1651 | RES 1.65K OHM 1/10W 1% | 1 | 0.077 | RHM1.65KHCT-ND (http://search.digikey.com/scripts/DkSearch/dksus.dll?Detail&name=RHM1.65KHCT-ND) | 0603 | 0.08
R88 | Rohm Semiconductor | MCR03EZPFX4701 | RES 4.70K OHM 1/10W 1% | 1 | 0.077 | RHM4.70KHCT-ND (http://search.digikey.com/scripts/DkSearch/dksus.dll?Detail&name=RHM4.70KHCT-ND) | 0603 | 0.08
S1 | C&K Components | KMR221GLFS | SWITCH TACT SPST-NO 200GF GW | 1 | 0.450 | 401-1427-1-ND (http://search.digikey.com/scripts/dksearch/dksus.dll?Detail&name=401-1427-1-ND) |  | 0.45
U26 | Diodes Inc | AP1509-50SG-13 | CONV DC-DC 2A 5.0V | 1 | 2.600 | AP1509-50SGDICT-ND (http://search.digikey.com/scripts/dksearch/dksus.dll?Detail&name=AP1509-50SGDICT-ND) | 8-SOIC | 2.60 |  | Price for onesies
U17 | Diodes Inc | AP1509-33SG-13 | CONV DC-DC 2A 3.3V | 1 | 2.600 | AP1509-33SGDICT-ND (http://search.digikey.com/scripts/dksearch/dksus.dll?Detail&name=AP1509-33SGDICT-ND) | 8-SOIC | 2.60 |  | Price for onesies
U29 | STMicroelectronics | KF25BD-TR | REG VLDO 2.5V INHIB | 1 | 1.370 | 497-7756-1-ND (http://search.digikey.com/scripts/dksearch/dksus.dll?Detail&name=497-7756-1-ND) | 8-SOIC | 1.37 |  | Price for onesies
Subtotal |  |  |  | 27 |  |  |  | 15.36
Transceivers/Inputs
C5,6,7,8,9,14,16,17,15,18,19,20,21,22,26,27,28,29,30,31,32,33,38,39,40 | Murata Electronics North America | GRM188R71E104KA01D | CAP CER .1UF 25V 10% X7R | 25 | 0.019 | 490-1524-1-ND (http://search.digikey.com/scripts/dksearch/dksus.dll?Detail&name=490-1524-1-ND) | 0603 | 0.48
J12,14,16,18,20,22,24,26,28,30,32,34 | Molex Connector Corporation | 35362-0250 | CONN HEADER 2POS 2MM VERT | 12 | 0.333 | WM18920-ND (http://search.digikey.com/scripts/dksearch/dksus.dll?Detail&name=WM18920-ND) |  | 4.00
J27,29,31 | Molex Connector Corporation | 35362-0350 | CONN HEADER 3POS 2MM VERT | 3 | 0.408 | WM18921-ND (http://search.digikey.com/scripts/dksearch/dksus.dll?Detail&name=WM18921-ND) |  | 1.22
J61,62,64,65,66,67 | Molex Connector Corporation | 35362-0450 | CONN HEADER 4POS 2MM VERT | 6 | 0.470 | WM18922-ND (http://search.digikey.com/scripts/dksearch/dksus.dll?Detail&name=WM18922-ND) |  | 2.82
J37,39,41,43,45,47,49,51,53,55,57,59 | Molex Connector Corporation | 35362-0650 | CONN HEADER 6POS 2MM VERT | 12 | 0.626 | WM18924-ND (http://search.digikey.com/scripts/dksearch/dksus.dll?Detail&name=WM18924-ND) |  | 7.51
J3,5,7,9 | Molex Connector Corporation | 35362-0850 | CONN HEADER 8POS 2MM VERT | 4 | 0.816 | WM18926-ND (http://search.digikey.com/scripts/dksearch/dksus.dll?Detail&name=WM18926-ND) |  | 3.26
Q1,2,3,4,5,6,7,8,9 | ON Semiconductor | NTA7002NT1G | MOSFET N-CH 30V 154MA | 9 | 0.270 | NTA7002NT1GOSCT-ND (http://search.digikey.com/scripts/dksearch/dksus.dll?Detail&name=NTA7002NT1GOSCT-ND) | SC-75-3 | 2.43
R3,4,5 | Rohm Semiconductor | MCR03EZPFX4701 | RES 4.70K OHM 1/10W 1% | 3 | 0.077 | RHM4.70KHCT-ND (http://search.digikey.com/scripts/DkSearch/dksus.dll?Detail&name=RHM4.70KHCT-ND) | 0603 | 0.23
U2 | Texas Instruments | MAX3221CPWR | DRVR/RCVR RS-232 1-CH | 1 | 1.930 | 296-9594-1-ND (http://search.digikey.com/scripts/DkSearch/dksus.dll?Detail&name=296-9594-1-ND) | 16-TSSOP | 1.93 |  | Price for onesies
U3,4,5,6 | Analog Devices Inc | ADM3490ARZ | TXRX RS-422/485 3.3V | 4 | 2.390 | ADM3490ARZ-ND (http://search.digikey.com/scripts/DkSearch/dksus.dll?Detail&name=ADM3490ARZ-ND) | 8-SOIC | 9.56 |  | Price for onesies
U7,8 | Texas Instruments | AM26LV32CD | QUAD DIFF LINE RCVR | 2 | 1.540 | 296-6794-5-ND (http://search.digikey.com/scripts/dksearch/dksus.dll?Detail&name=296-6794-5-ND) | 16-SOIC | 3.08 |  | Price for onesies
U11,12 | Texas Instruments | AM26LV31EIDR | DRIVER DIFF QUAD LV HS | 2 | 1.750 | 296-24690-1-ND (http://search.digikey.com/scripts/dksearch/dksus.dll?Detail&name=296-24690-1-ND) | 16-SOIC | 3.50 |  | Price for onesies
U22,23,24 | Texas Instruments | INA2321EA/250 | OPAMP INSTR R-R DUAL | 3 | 5.850 | INA2321EACT-ND (http://search.digikey.com/scripts/DkSearch/dksus.dll?Detail&name=INA2321EACT-ND) | 14-TSSOP | 17.55 |  | Price for onesies
U15,16,30 | Texas Instruments | SN74LVC245ADWR | BUS TRANSCEIVER 8BIT | 3 | 0.550 | 296-1232-1-ND (http://search.digikey.com/scripts/dksearch/dksus.dll?Detail&name=296-1232-1-ND) | 20-SOIC (7.5mm Width) | 1.65
U9,10,18 | Texas Instruments | AM26LS32ACDR | QUAD DIFF LINE RCVR | 3 | 0.950 | 296-1011-1-ND (http://search.digikey.com/scripts/DkSearch/dksus.dll?Detail&name=296-1011-1-ND) | 16-SOIC | 2.85 |  | Price for onesies
U13,14 | Avago Technologies US Inc. | HCTL-2032-SC | DECODER/COUNTER 32BIT | 2 | 11.250 | 516-1885-5-ND | 32-SOIC | 22.50
Y1 | ECS Inc | ECS-3951M-330-B-TR | OSC 33.000 MHZ 5.0V | 1 | 4.725 | XC785CT-ND (http://search.digikey.com/scripts/dksearch/dksus.dll?Detail&name=XC785CT-ND) | 7.50mm x 5.00mm | 4.73
Subtotal |  |  |  | 95 |  |  |  | 89.30

Sheet: Total BOM
Ref. Des. | Manufacture | Manufacture # | Description | Digikey # | Quantity | 5x Quantity | # Ordered | In Hand
C1,2,3,4,5,6,7,8,9,10,11,12,13,14,15,16,17,18,19,20,21,22,25,26,27,28,29,30,31,32,33,34,35,36,37,38,39,39,40,40,45,46,47,48,49,50,51,53,54,55,56,57,58,59,60,61,62,63,65,66,67,68,73,82,84 | Murata Electronics North America | GRM188R71E104KA01D | CAP CER .1UF 25V 10% X7R | 490-1524-1-ND | 65 | 325 | 500 | 500
C41,42,43,44 | Taiyo Yuden | TMK316BJ106KL-T | CAP CER 10UF 25V X5R | 587-1337-1-ND | 4 | 20 | 30
C52,80 | Kemet | C0603C180J5GACTU | CAP CERAMIC 18PF 50V NP0 | 399-1052-1-ND | 2 | 10 | 20
C64 | Kemet | C0603C225K9PACTU | CAP CERAMIC 2.2UF 6.3V X5R | 399-3362-1-ND | 1 | 5 | 10
D1,2,7 | Vishay/General Semiconductor | SSC53L-E3/57T | DIODE SCHOTTKY 5A 30V | SSC53L-E3/57TGICT-ND | 3 | 15 | 18 | 18
D3,4,5,6 | OSRAM Opto Semiconductors Inc | LG L29K-G2J1-24-Z | LED SMARTLED GREEN 570NM | 475-2709-1-ND | 4 | 20 | 25
J12,14,16,18,20,22,24,26,28,30,32,34 | Molex Connector Corporation | 35362-0250 | CONN HEADER 2POS 2MM VERT | WM18920-ND | 12 | 60 | 65
J2 | Pulse | JG0-0031NL | CONN PULSEJACK 2PORT POETHERNET | 553-1361-ND | 1 | 5 | 5 | 5
J27,29,31 | Molex Connector Corporation | 35362-0350 | CONN HEADER 3POS 2MM VERT | WM18921-ND | 3 | 15 | 20 | 20
J3,5,7,9 | Molex Connector Corporation | 35362-0850 | CONN HEADER 8POS 2MM VERT | WM18926-ND | 4 | 20 | 25 | 25
J37,39,41,43,45,47,49,51,53,55,57,59 | Molex Connector Corporation | 35362-0650 | CONN HEADER 6POS 2MM VERT | WM18924-ND | 12 | 60 | 65 | 65
J61,62,64,65,66,67,80 | Molex Connector Corporation | 35362-0450 | CONN HEADER 4POS 2MM VERT | WM18922-ND | 7 | 35 | 40
L1,2,5,6,7,8 | TDK Corporation | MMZ1608R301A | FERRITE CHIP 300 OHM 500MA | 445-2171-1-ND | 6 | 30 | 40
L3,4 | Taiyo Yuden | NR10050T470M | INDUCTOR 47UH 2A 20% | 587-1700-1-ND | 2 | 10 | 10 | 10
Q1,2,3,4,5,6,7,8,9,13,14,15 | ON Semiconductor | NTA7002NT1G | MOSFET N-CH 30V 154MA | NTA7002NT1GOSCT-ND | 12 | 60 | 65
R1,75 | Rohm Semiconductor | MCR03EZPFX8060 | RES 806 OHM 1/10W 1% | RHM806HCT-ND | 2 | 10 | 20
R2 | Rohm Semiconductor | MCR03EZPFX1651 | RES 1.65K OHM 1/10W 1% | RHM1.65KHCT-ND | 1 | 5 | 10
R3,4,5,37,38,39,40,41,42,43,44,45,46,48,49,50,51,52,53,54,55,56,57,58,59,60,61,62,63,64,65,72,73,74,76,77,80,81,88 | Rohm Semiconductor | MCR03EZPFX4701 | RES 4.70K OHM 1/10W 1% | RHM4.70KHCT-ND | 39 | 195 | 210
R36,47 | Rohm Semiconductor | MCR03EZPFX6491 | RES 6.49K OHM 1/10W 1% | RHM6.49KHCT-ND | 2 | 10 | 20
R66,67,68,69,82,83,84,85 | Rohm Semiconductor | MCR03EZPFX49R9 | RES 49.9 OHM 1/10W 1% | RHM49.9HCT-ND | 8 | 40 | 50
R70,71 | Rohm Semiconductor | MCR03EZPFX64R9 | RES 64.9 OHM 1/10W 1% | RHM64.9HCT-ND | 2 | 10 | 20
R78 | Rohm Semiconductor | MCR03EZPFX1102 | RES 11.0K OHM 1/10W 1% | RHM11.0KHCT-ND | 1 | 5 | 10
R79 | Rohm Semiconductor | MCR03EZPFX4020 | RES 402 OHM 1/10W 1% | RHM402HCT-ND | 1 | 5 | 10 | 10
S1 | C&K Components | KMR221GLFS | SWITCH TACT SPST-NO 200GF GW | 401-1427-1-ND | 1 | 5 | 7
U1,21 | Atmel | ATXMEGA128A3-AU | MCU AVR 128K FLASH | ATXMEGA128A3-AU-ND | 2 | 10 | 10
U11,12 | Texas Instruments | AM26LV31EIDR | DRIVER DIFF QUAD LV HS | 296-24690-1-ND | 2 | 10 | 11
U13,14 | Avago Technologies US Inc. | HCTL-2032-SC | DECODER/COUNTER 32BIT | 516-1885-5-ND | 2 | 10 | 10 | 10
U15,16,30 | Texas Instruments | SN74LVC245ADWR | BUS TRANSCEIVER 8BIT | 296-1232-1-ND | 3 | 15 | 16
U17 | Diodes Inc | AP1509-33SG-13 | CONV DC-DC 2A 3.3V | AP1509-33SGDICT-ND | 1 | 5 | 6 | 6
U19,20 | Micrel Inc | KSZ8721B TR | TXRX PHY 10/100 2.5V | 576-1026-1-ND | 2 | 10 | 10 | 10
U2 | Texas Instruments | MAX3221CPWR | DRVR/RCVR RS-232 1-CH | 296-9594-1-ND | 1 | 5 | 6
U22,23,24 | Texas Instruments | INA2321EA/250 | OPAMP INSTR R-R DUAL | INA2321EACT-ND | 3 | 15 | 15
U26 | Diodes Inc | AP1509-50SG-13 | CONV DC-DC 2A 5.0V | AP1509-50SGDICT-ND | 1 | 5 | 6
U27 | Rohm Semiconductor | BR24S16FVT-WE2 | EEPROM 16KBIT 400KHZ | BR24S16FVT-WE2CT-ND | 1 | 5 | 6
U28 | Beckhoff | ET1200 | EtherCAT ASIC |  | 1 | 5
U29 | STMicroelectronics | KF25BD-TR | REG VLDO 2.5V INHIB | 497-7756-1-ND | 1 | 5 | 6
U3,4,5,6 | Analog Devices Inc | ADM3490ARZ | TXRX RS-422/485 3.3V | ADM3490ARZ-ND | 4 | 20 | 21 | 21
U7,8 | Texas Instruments | AM26LV32CD | QUAD DIFF LINE RCVR | 296-6794-5-ND | 2 | 10 | 11
U9,10,18 | Texas Instruments | AM26LS32ACDR | QUAD DIFF LINE RCVR | 296-1011-1-ND | 3 | 15 | 16
Y1 | ECS Inc | ECS-3951M-330-B-TR | OSC 33.000 MHZ 5.0V | XC785CT-ND | 1 | 5 | 5
Y2 | TXC Technology Inc | 7M-25.000MAAJ-T | CRYSTAL 25.000 MHZ 18PF | 887-1132-1-ND | 1 | 5 | 5
