alireza1405/medulla/hardware/medulla.1/Schematic/medulla.1.pdf

6 | 5 | 4 | 3 | 2 | 1

D

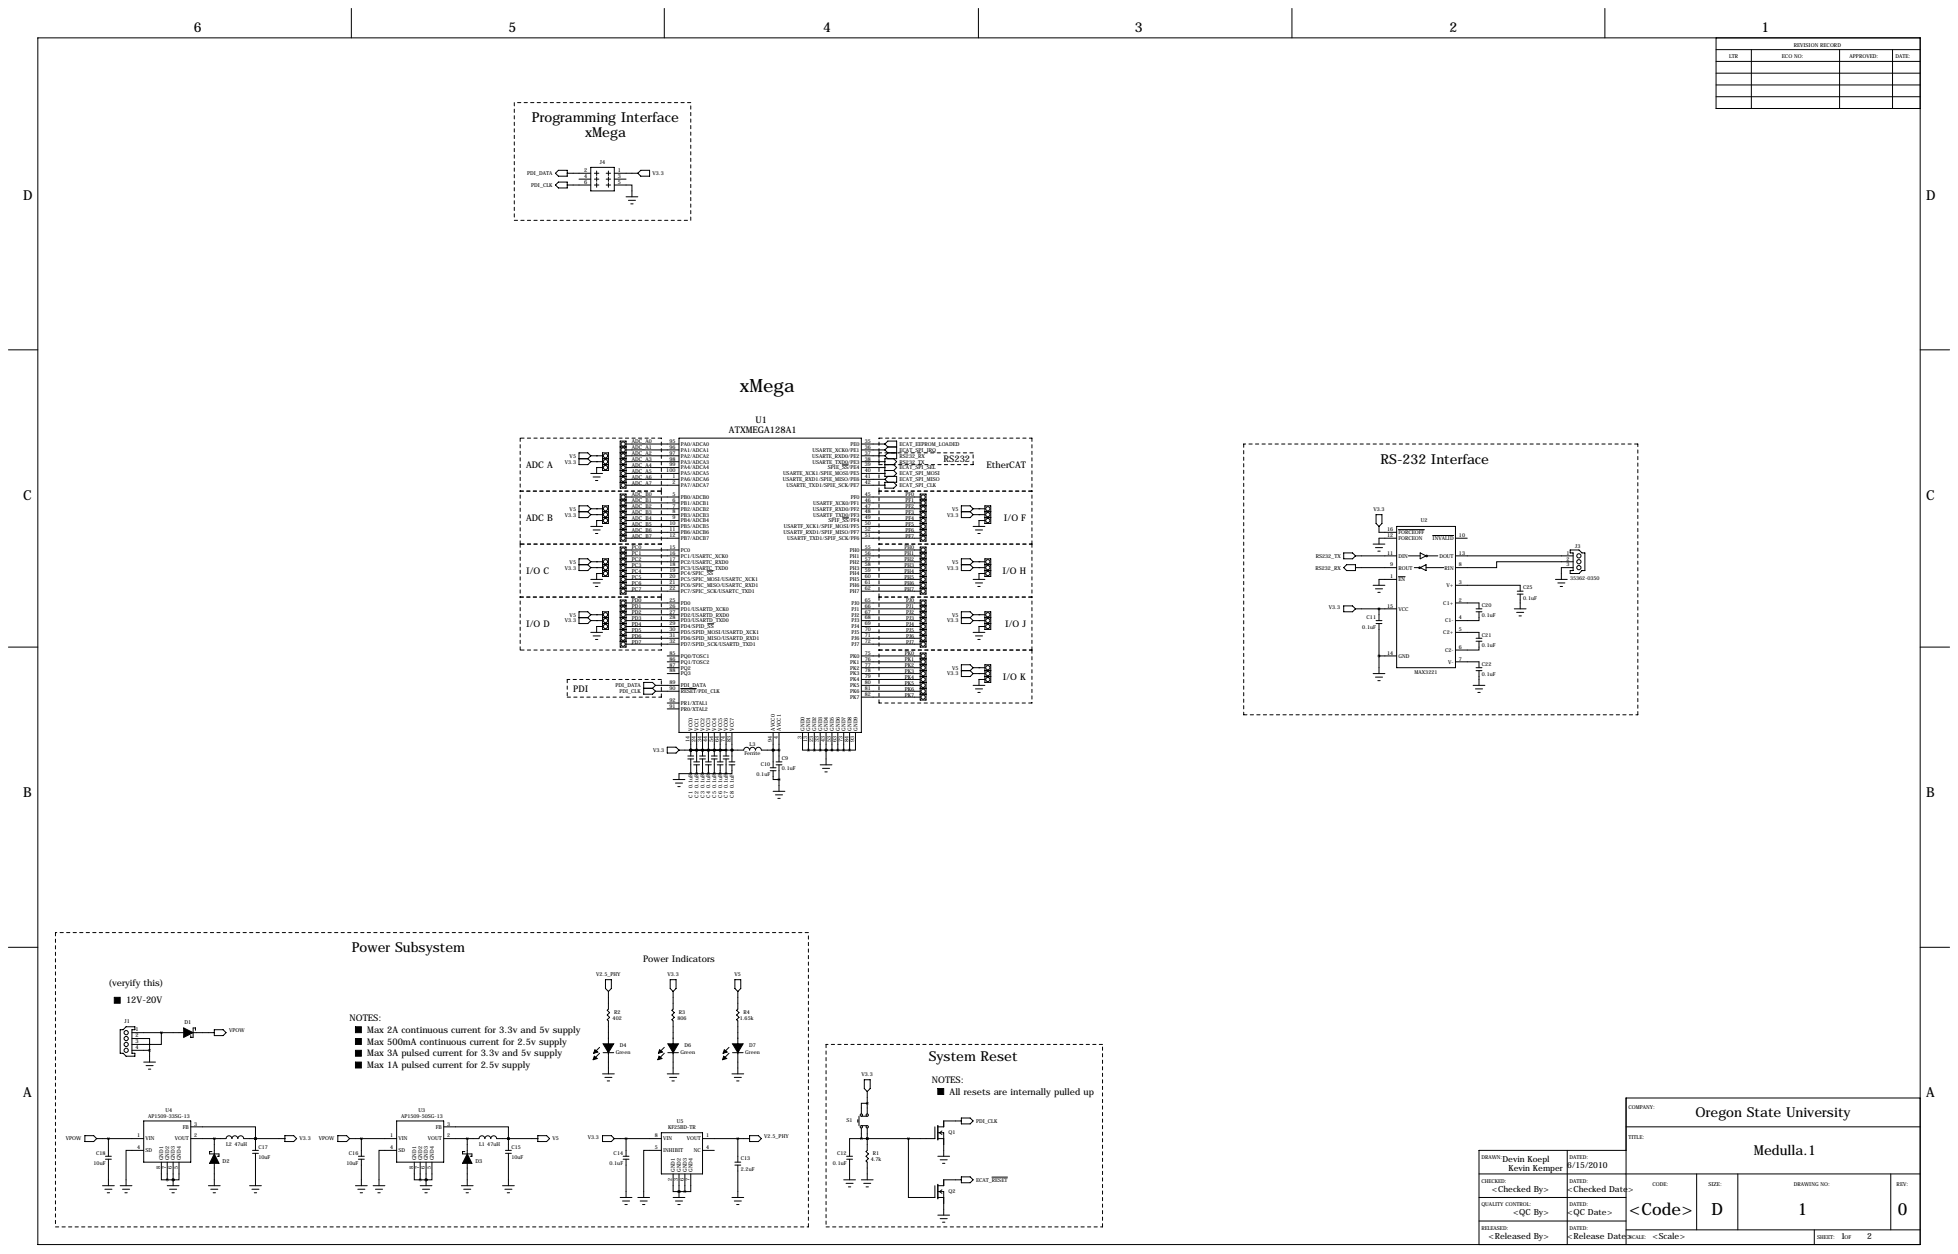
[picture p4: page 1]

REVISION RECORD

LTR | ECO NO: | APPROVED: | DATE:

NOTES:
Max 2A continuous current for 3.3v and 5v supply
Max 500mA continuous current for 2.5v supply
Max 3A pulsed current for 3.3v and 5v supply
Max 1A pulsed current for 2.5v supply

All resets are internally pulled up

DRAWN: Devin Koepl Kevin Kemper | DATED: 6/15/2010

CHECKED: <Checked By> | DATED: <Checked Date> | CODE: <Code> | SIZE: D | DRAWING NO: 1 | REV: 0

QUALITY CONTROL: <QC By> | DATED: <QC Date>

RELEASED: <Released By> | DATED:

<Scale> SCALE: | 1 2 SHEET: OF

D

D

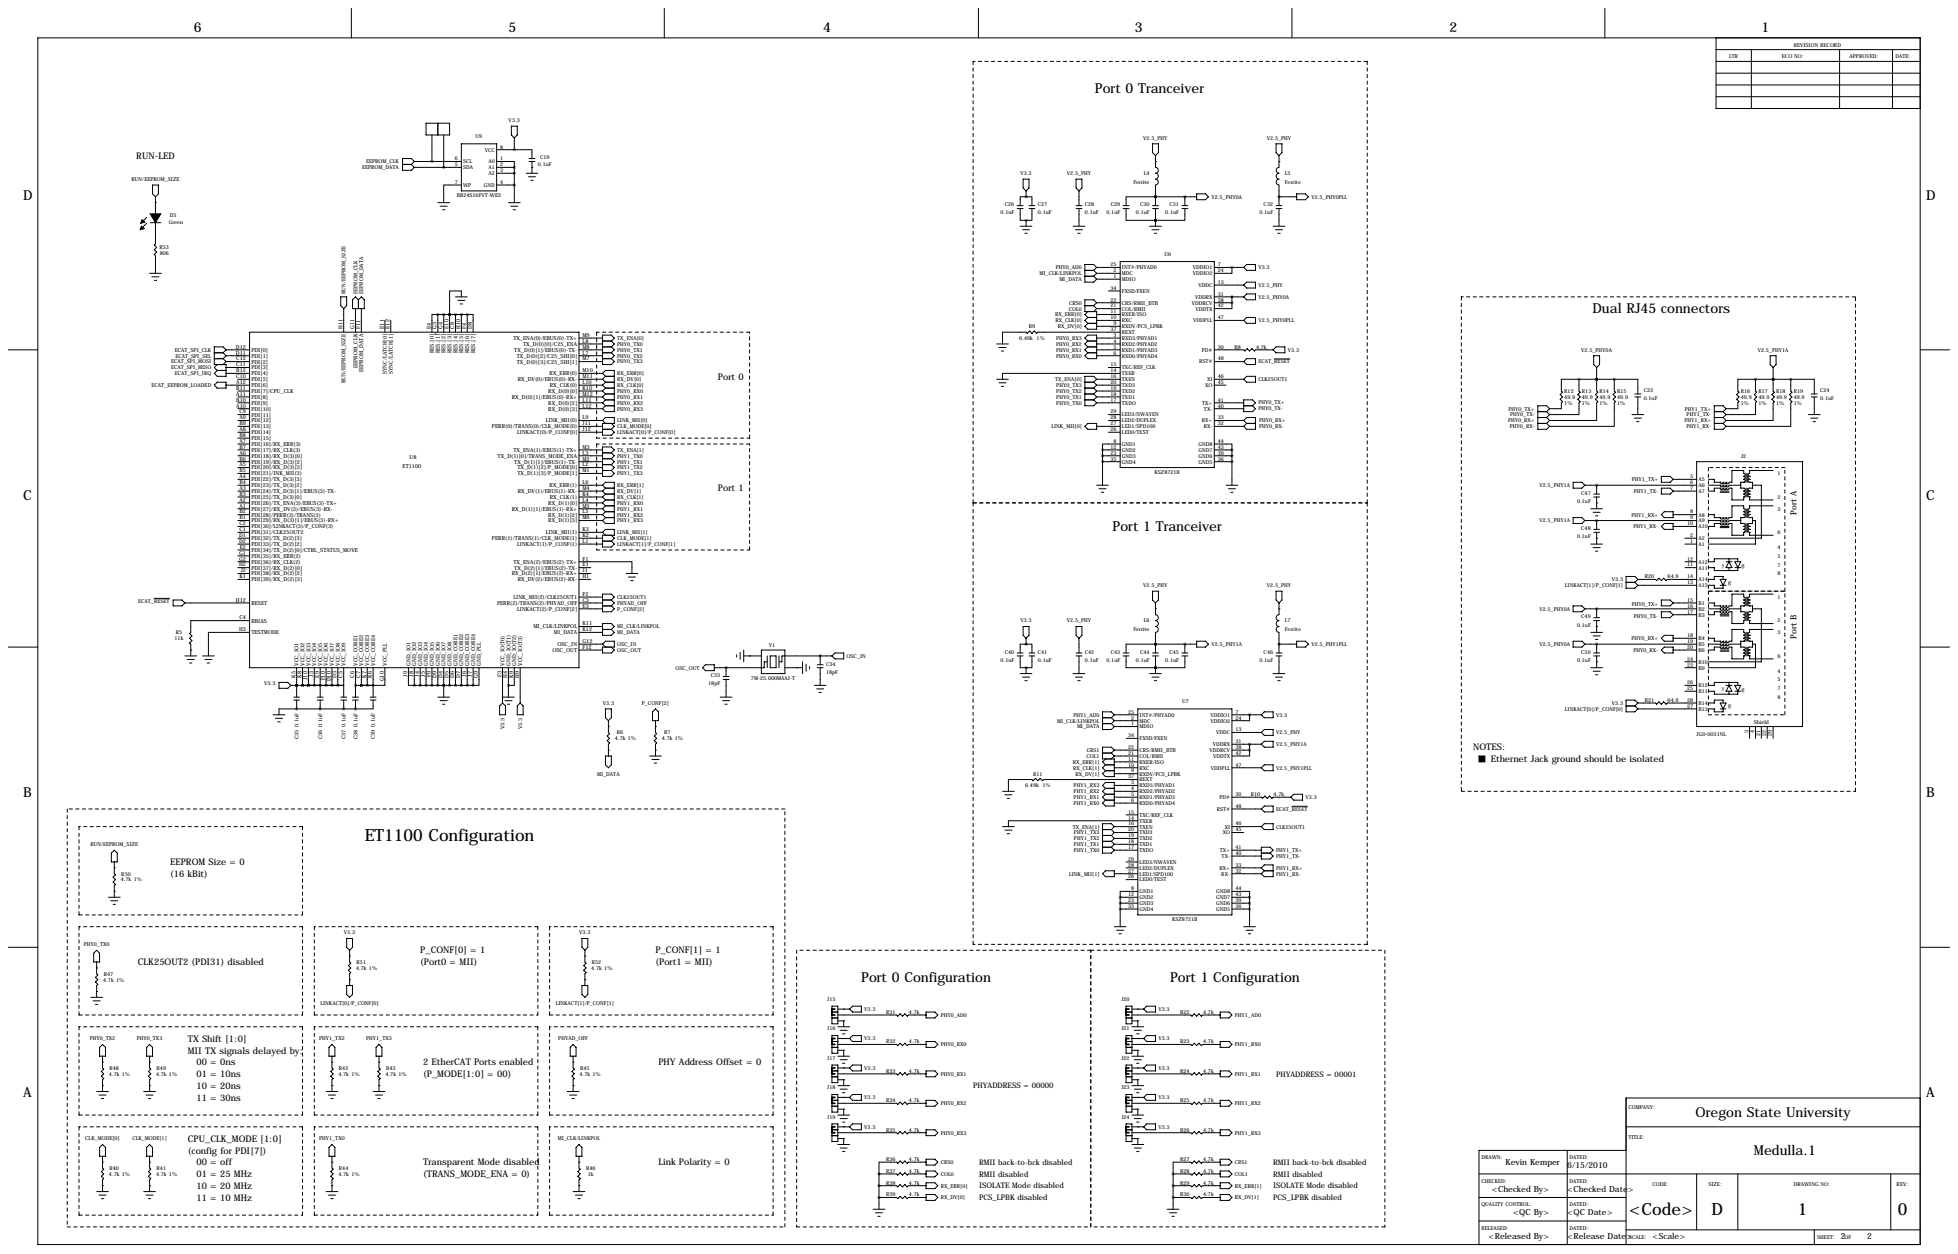
[picture p5: page 2]

REVISION RECORD

LTR | ECO NO: | APPROVED: | DATE:

Port 0 Tranceiver V2.5_PHY L4 Ferrite | U6

NOTES:
Ethernet Jack ground should be isolated

RMII back-to-bck disabled
RMII disabled
ISOLATE Mode disabled
PCS_LPBK disabled

DRAWN: Kevin Kemper | DATED: 6/15/2010

CHECKED: <Checked By> | DATED: <Checked Date> | CODE: <Code> | SIZE: D | DRAWING NO: 1 | REV: 0

QUALITY CONTROL: <QC By> | DATED: <QC Date>

RELEASED: <Released By> | DATED:

<Scale> SCALE: | 2 2 SHEET: OF
