alireza1405/medulla/hardware/medulla.0/Schematic/medulla.0.pdf

6 | 5 | 4 | 3 | 2 | 1

D

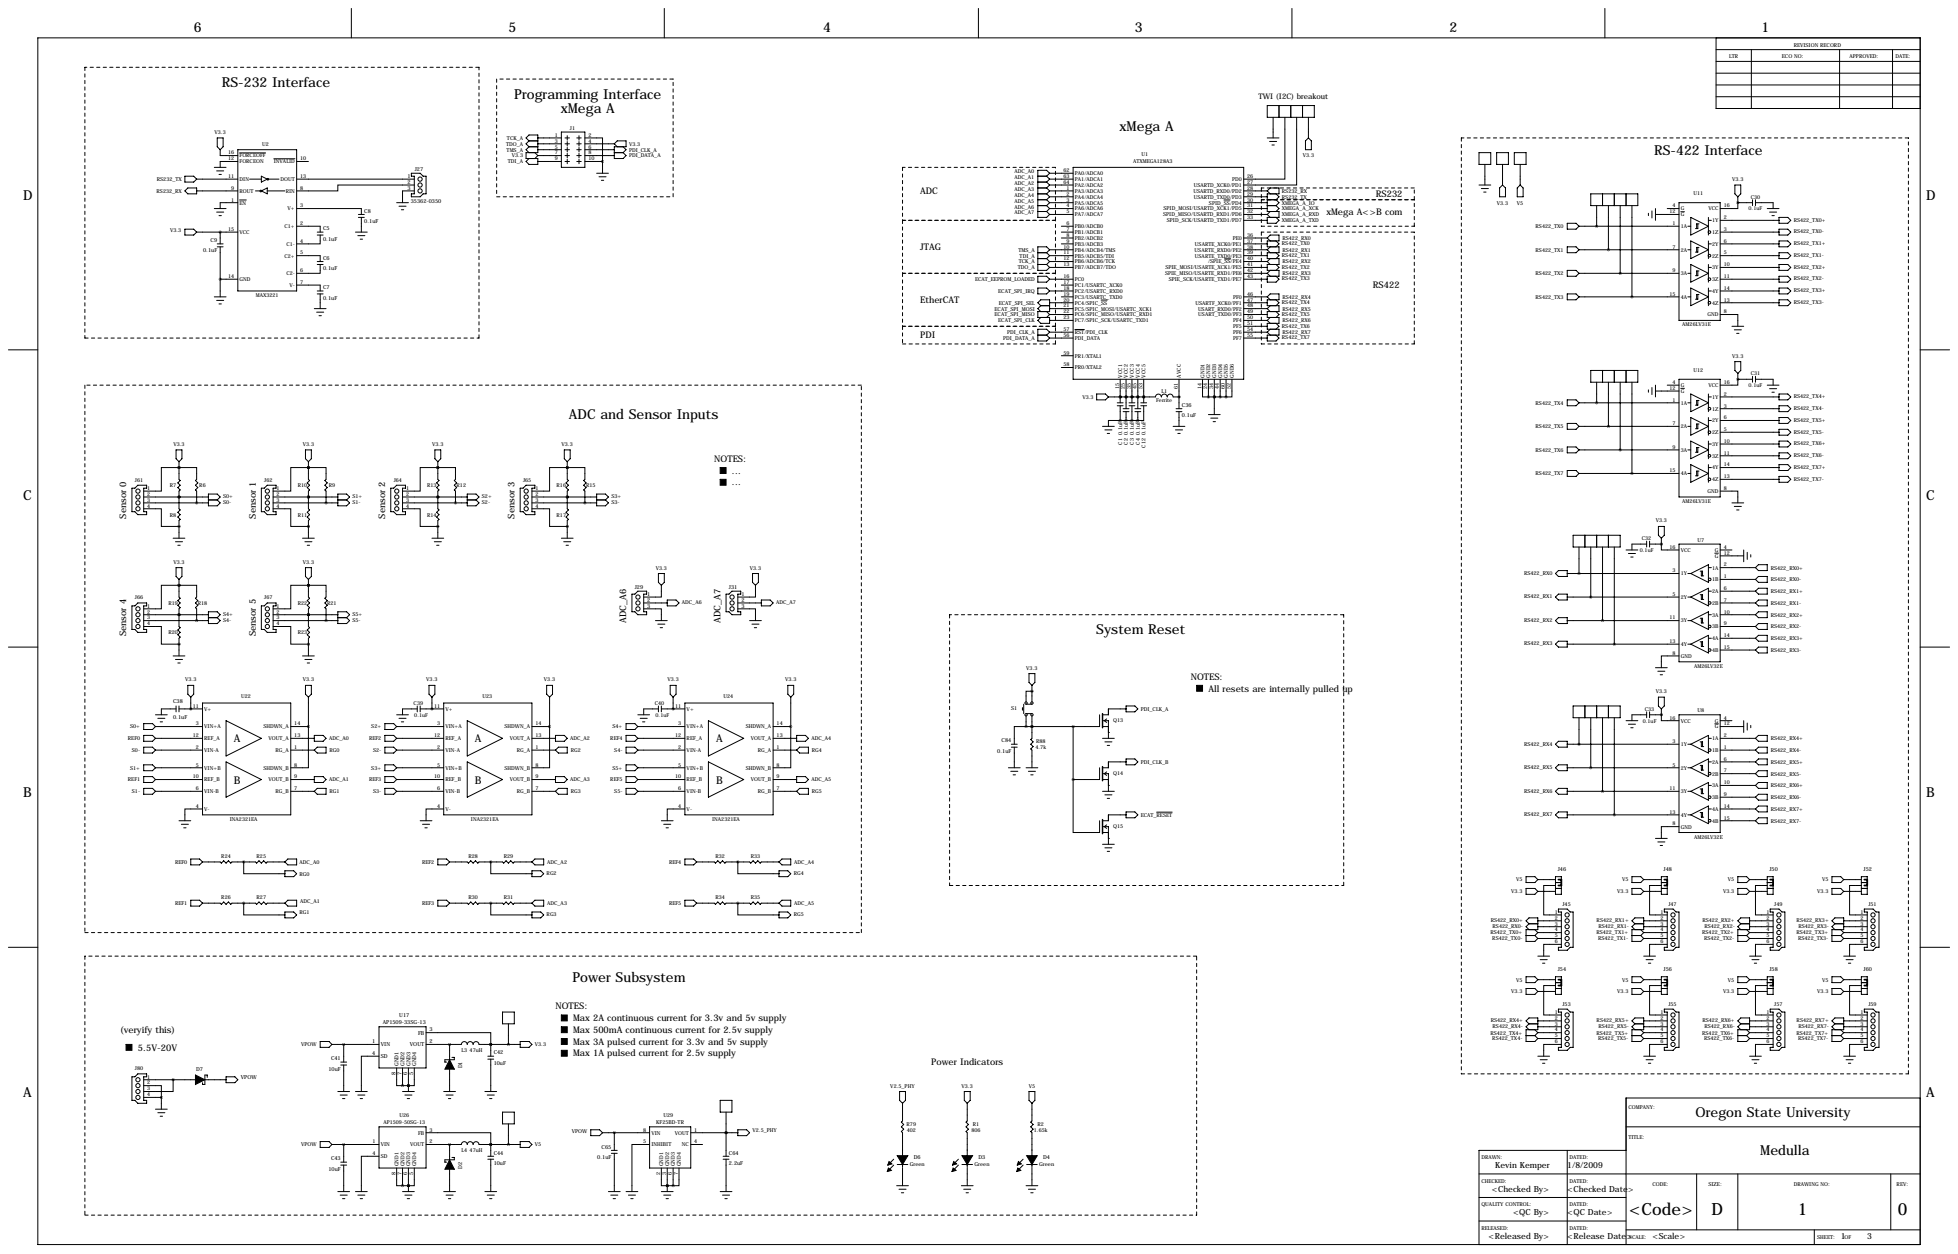
[picture p6: page 1]

REVISION RECORD

LTR | ECO NO: | APPROVED: | DATE:

ADC and Sensor Inputs

NOTES:
All resets are internally pulled up

Max 2A continuous current for 3.3v and 5v supply
Max 500mA continuous current for 2.5v supply
Max 3A pulsed current for 3.3v and 5v supply
Max 1A pulsed current for 2.5v supply

DRAWN: Kevin Kemper | DATED:

CHECKED: <Checked By> | DATED: <Checked Date> | CODE: <Code> | SIZE: D | DRAWING NO: 1 | REV: 0

QUALITY CONTROL: <QC By> | DATED: <QC Date>

RELEASED: <Released By> | DATED:

<Scale> SCALE: | 1 3 SHEET: OF

D

D

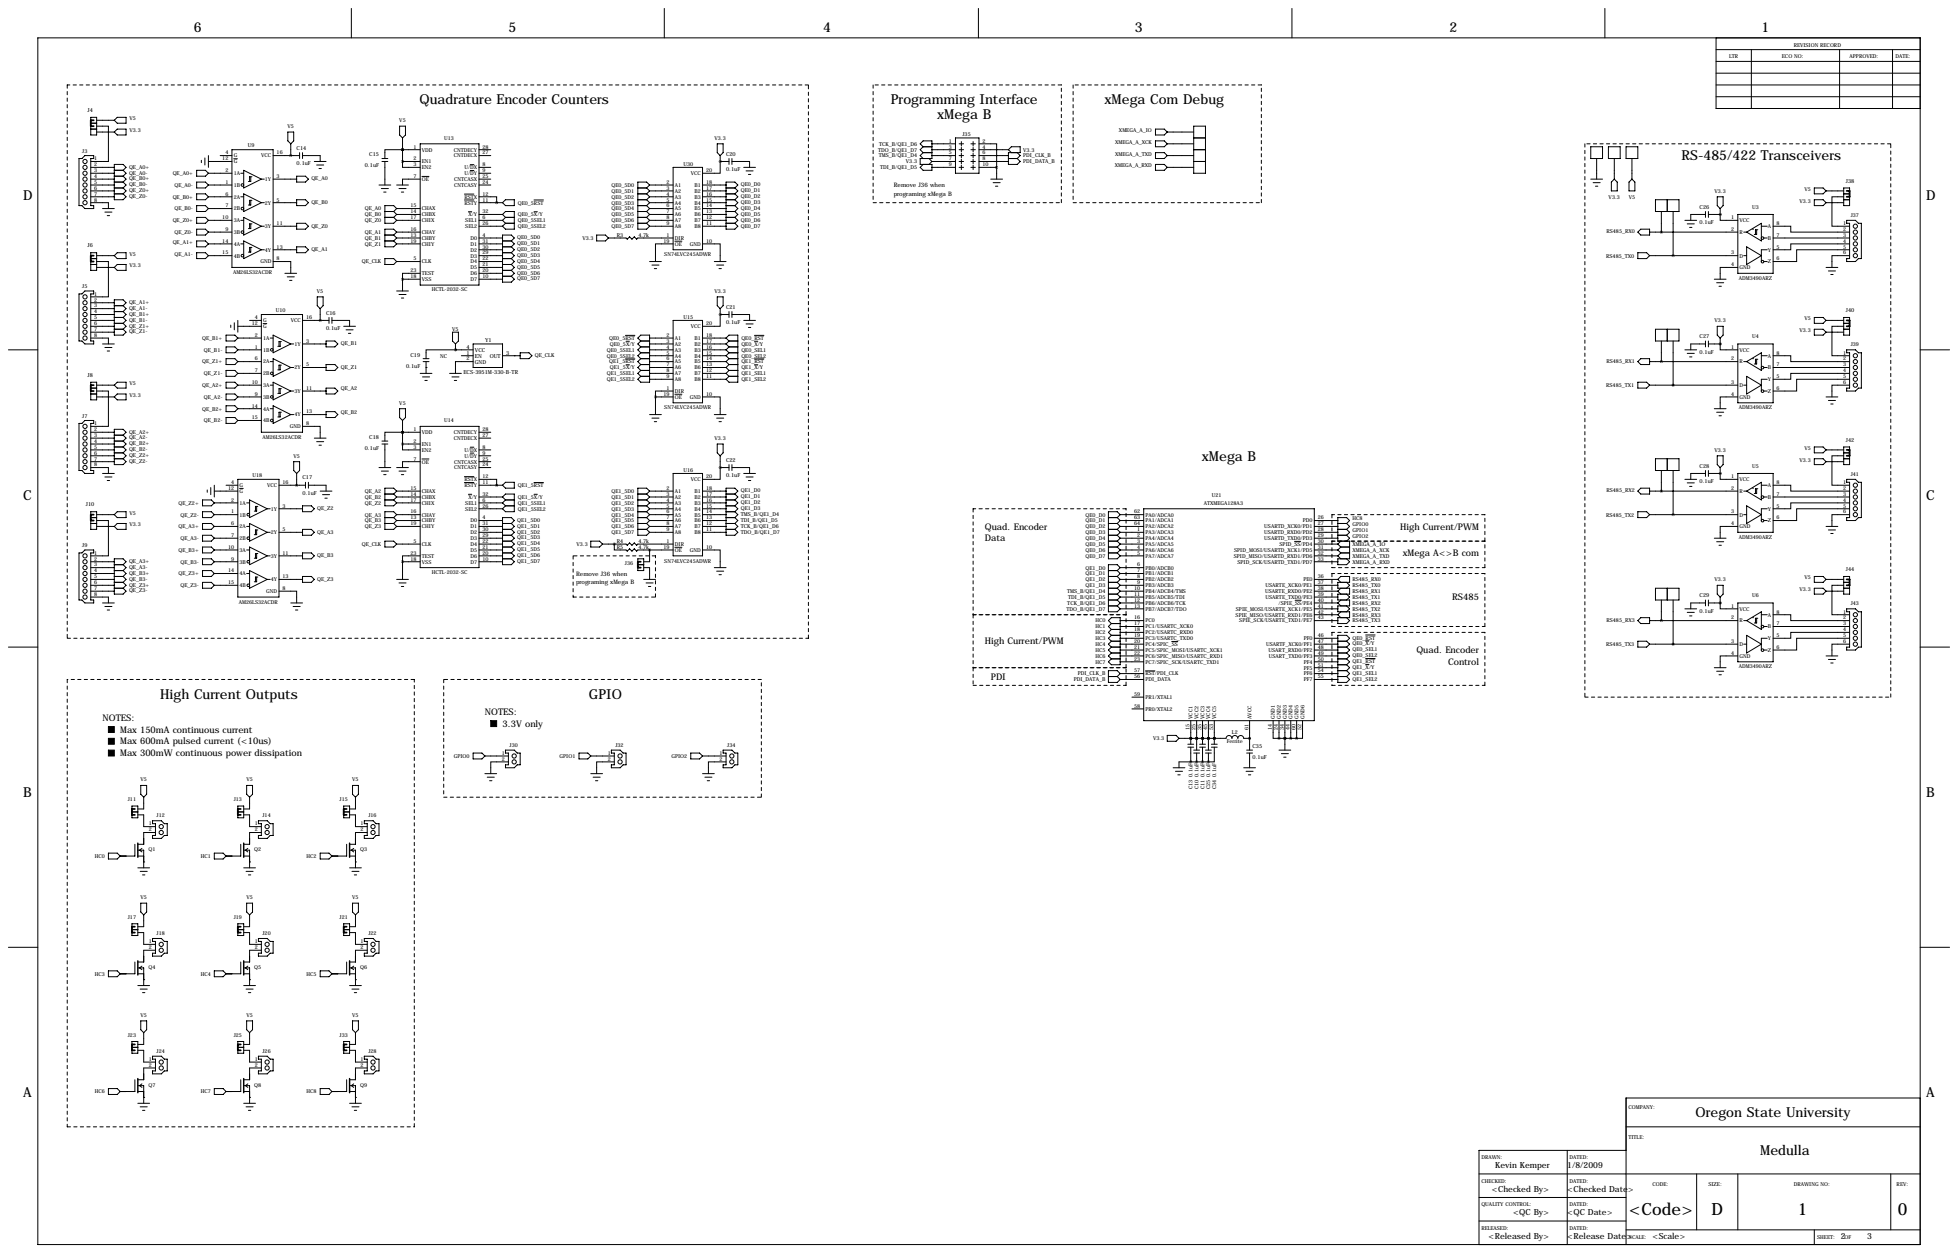
[picture p7: page 2]

NOTES:
Max 150mA continuous current
Max 600mA pulsed current (<10us)
Max 300mW continuous power dissipation

D

D

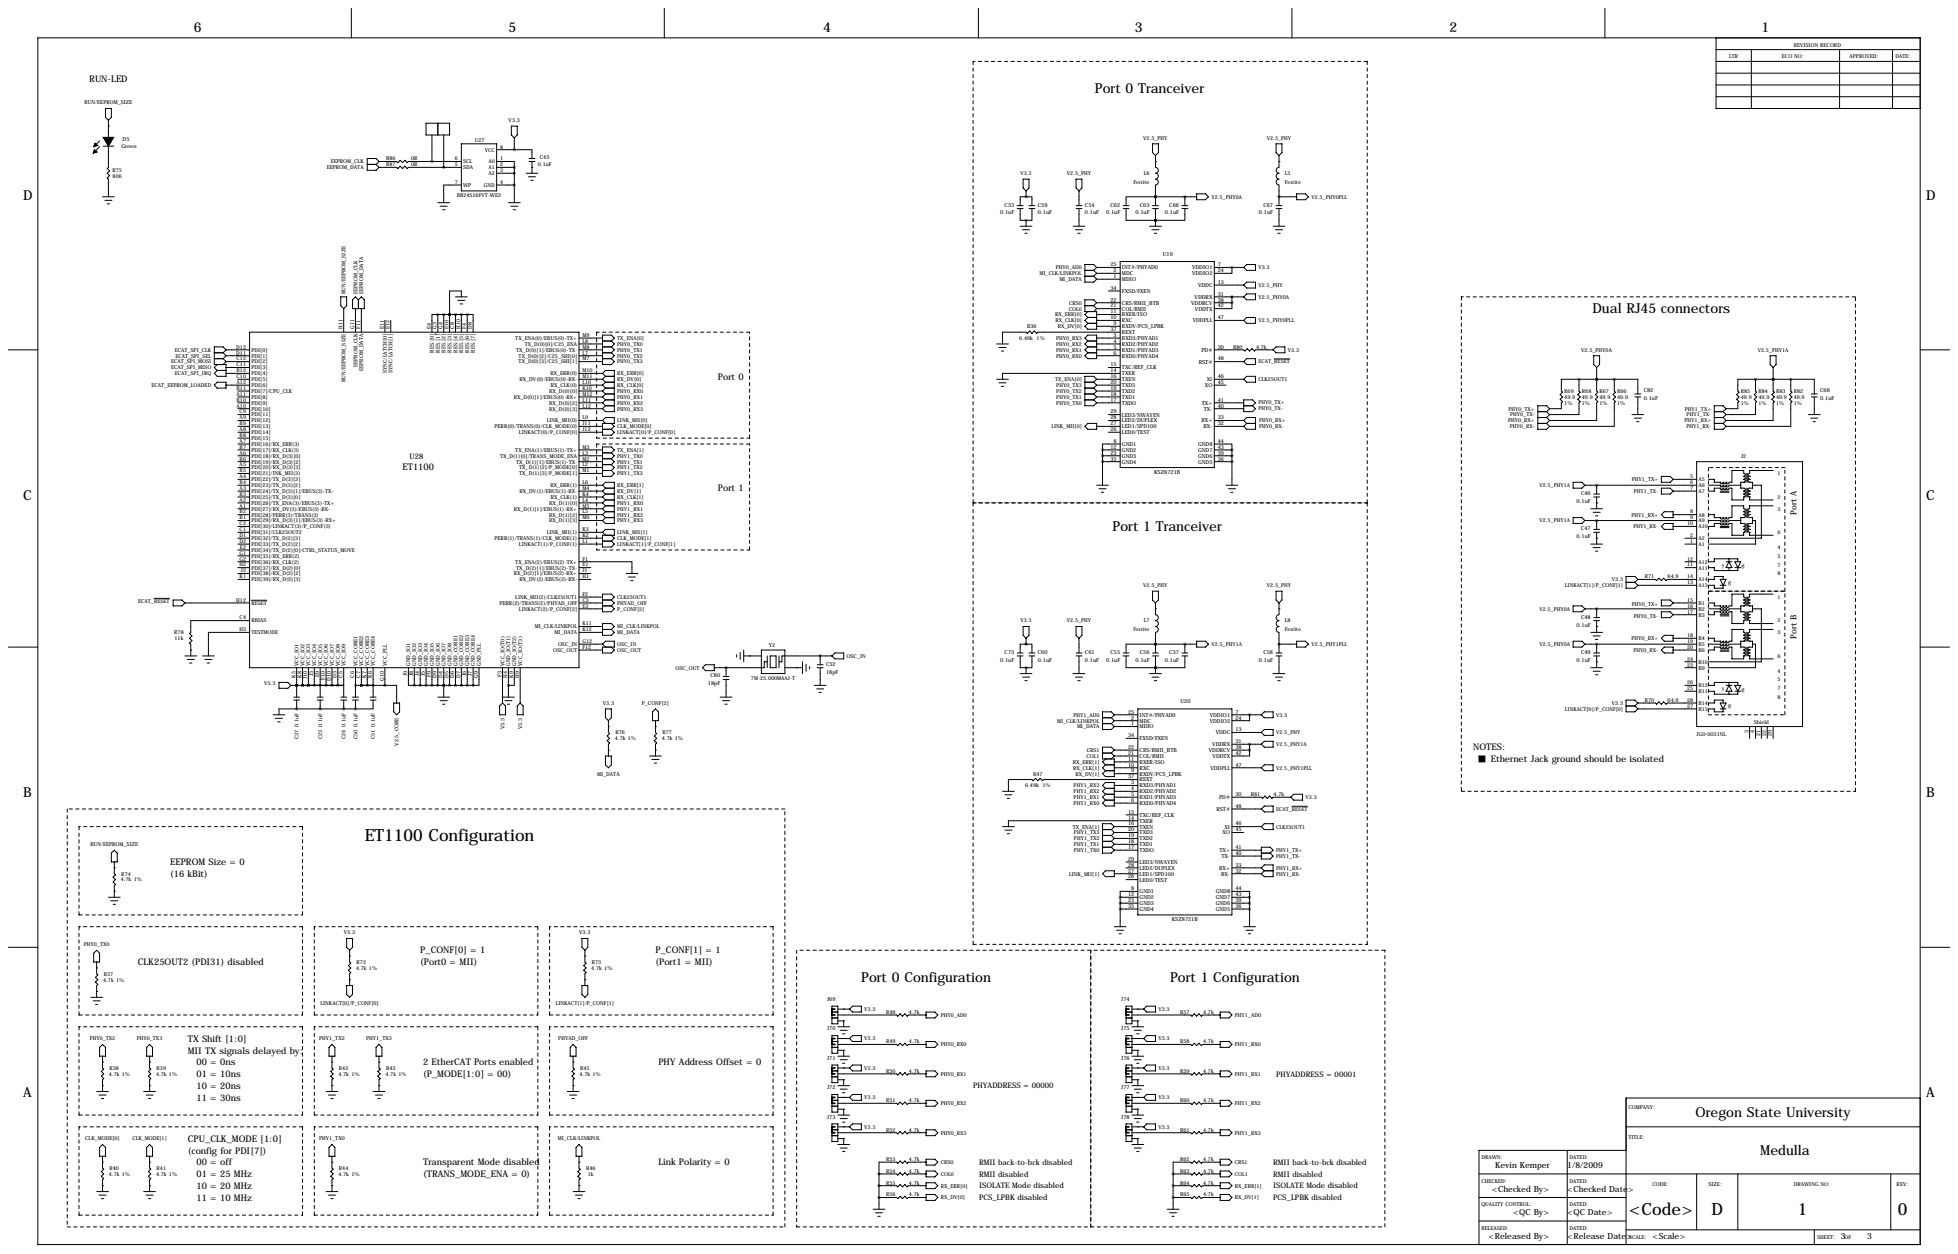
[picture p8: page 3]

NOTES:
Ethernet Jack ground should be isolated

RMII back-to-bck disabled
