alireza1405/medulla/hardware/medulla.1.5/CAM-2013/PrintBottom.pdf

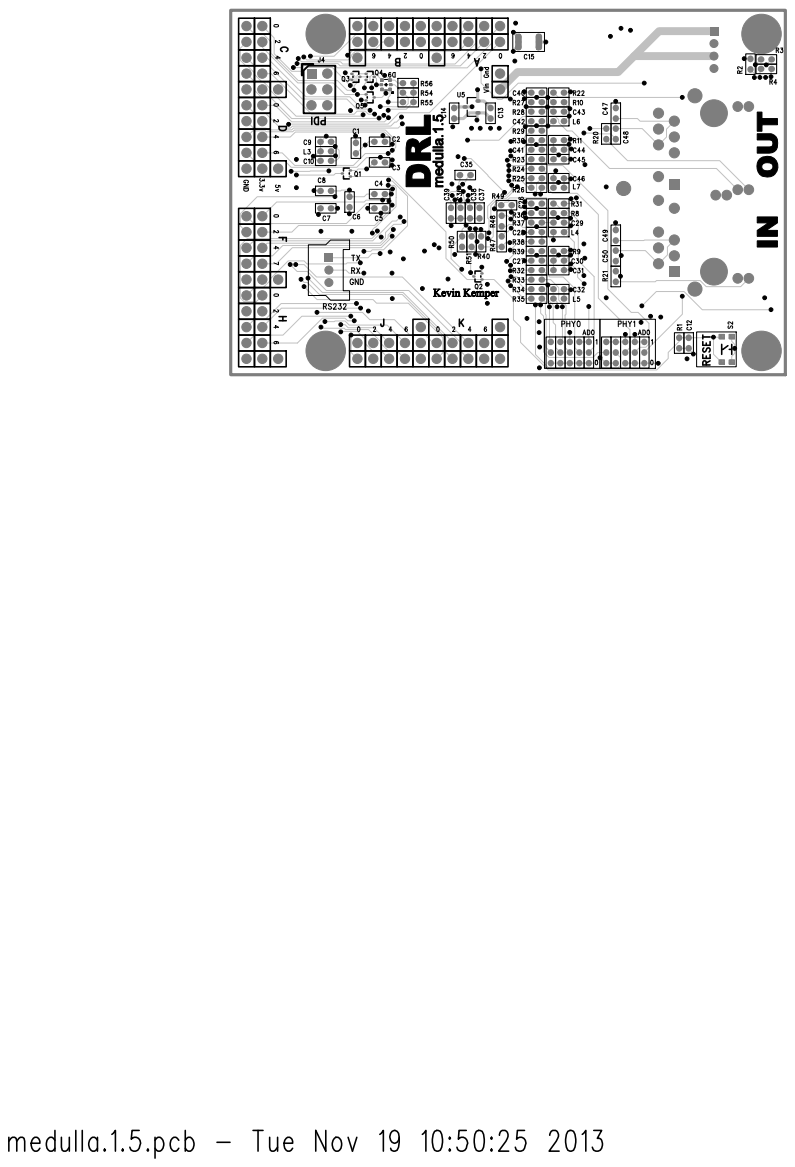
[picture p9: page 1]
