alireza1405/medulla/hardware/medulla.1.5/CAM-2013/PrintGnd.pdf

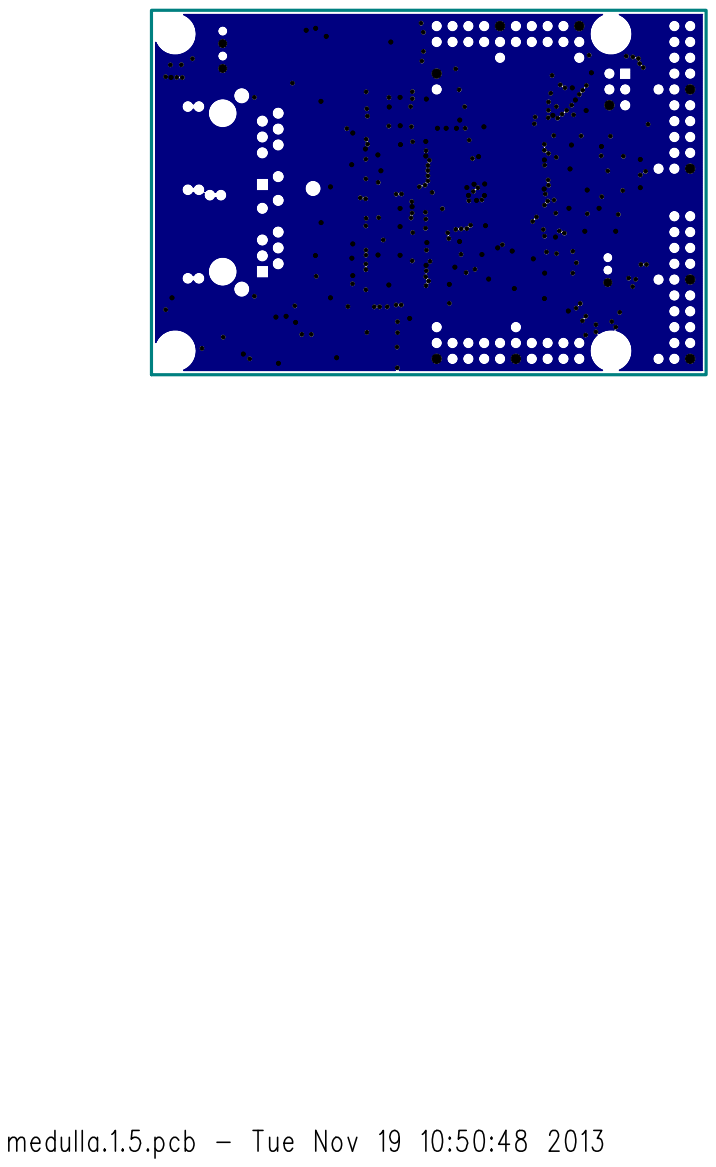
[picture p10: page 1]
