alireza1405/medulla/hardware/medulla.1.5/CAM-2013/PrintPower.pdf

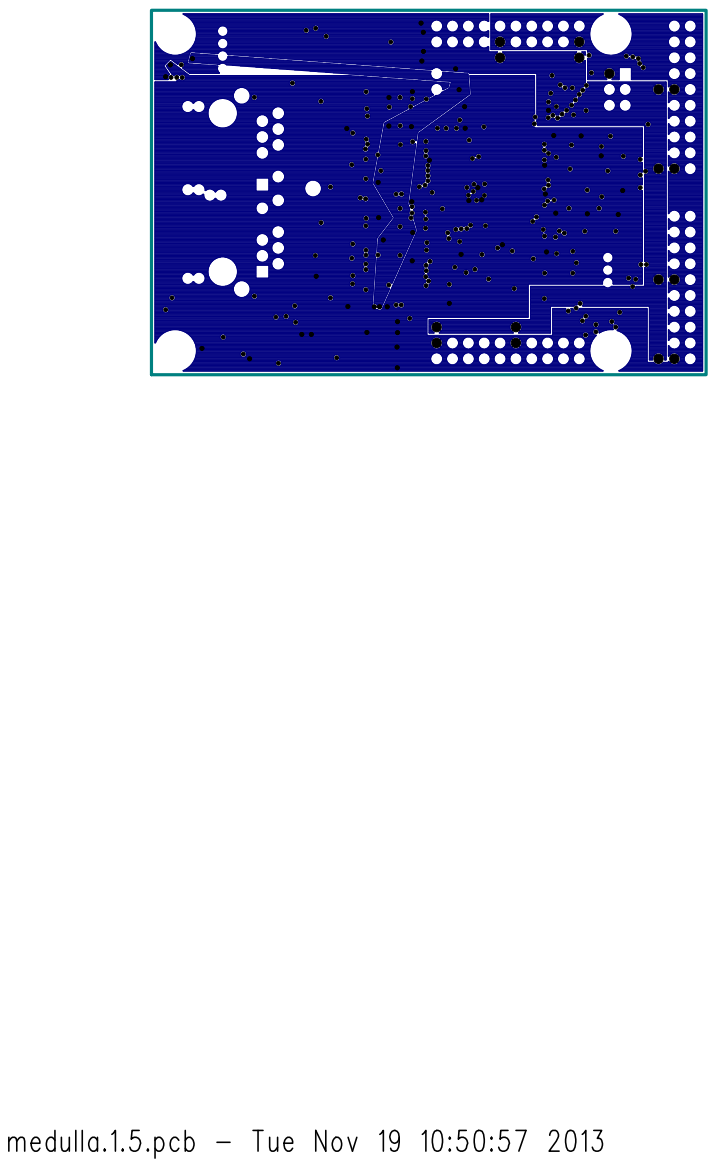
[picture p11: page 1]
