alireza1405/medulla/hardware/medulla.1.5/CAM-2013/PrintTop.pdf

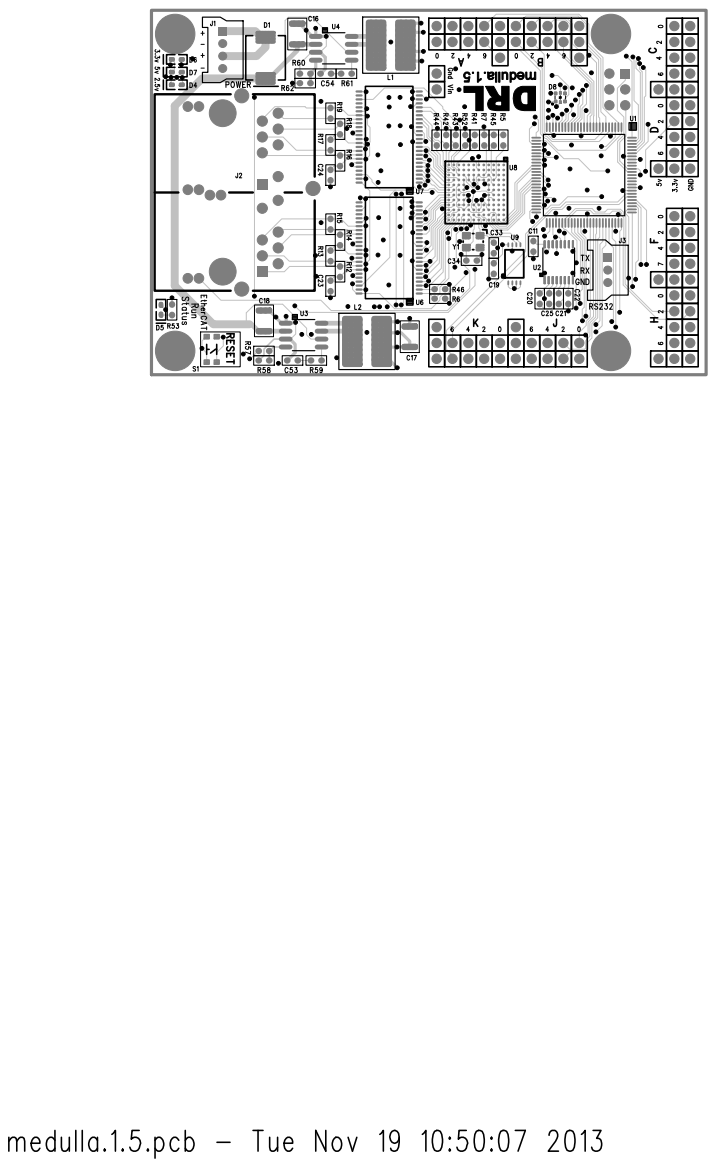
[picture p12: page 1]
