alireza1405/medulla/(list of files, drawings)

Other design files:
hardware/medulla.0/PCB/medulla.0.pcb
hardware/medulla.1.5/PCB/medulla.1.5.pcb
hardware/medulla.1/PCB/medulla.1.pcb
