alireza1405/medulla/firmware/medulla_lib/include/io_pin.h

#ifndef IO_PIN_H
#define IO_PIN_H
/** @file
 *  @brief This library provides a basic abstraction layer for xMega IO.
 *  
 *  The IO Pin library provides a light weight abstrcation layer for managing the
 *  IO pins on the xMega. This library not only makes basic DIO easier, but it is
 *  used in the interface of many of the other libraries.
 */

#include <avr/io.h>

/** @brief Struct containing all the important information about a pin.
 *
 *  The io_pin_t type is a struct that can be used to describe any GPIO pin on
 *  the xMega. Once the struct has been initialized using the io_init_pin macro
 *  it contains pointers to all of the addresses nessesary to use the pin.
 */
typedef struct {
	PORT_t *io_port;		/**< Pointer to the pin's IO port */
	uint8_t pin;			/**< Zero indexed number of the pin on the port */
	register8_t *control_reg;	/**< Pointer to the control register for the pin */
} io_pin_t;

/** @brief Enum used to specify a pin's direction.
 *  
 *  This enum is used to specfy the direction of an IO pin in this library. The
 *  values of the enum have been chosen such that the integer value can be added
 *  to the PORT_t address to access either the DIRSET or DIRCLR registers.
 */
typedef enum {
	io_output = 1, 
	io_input = 2
} io_pin_direction_t;

/** @brief Enum used to specify the logic level of a DIO pin
 *
 *   This enum specifies a logic level (0 or 3.3V) or an output or input on the
 *  xMega. Unlike the io_pin_direction these values do not directly associate
 *  with the OUTSET or OUTCLR registers of the PORT. Instead, a value of 6 must
 *  be added to the PORT_t address and then the enum must be added. This makes
 *  it possible to put this value directly into an if statement and have a high
 *  vale interpreted as true, and a low value interpreted as false.
 */
typedef enum {
	io_high = 1,
	io_low = 0
} io_pin_level_t;

/** @brief Initializes an io_pin_t struct.
 *
 *  The IO_init_pin function creates a struct definition for an io_pin_t struct.
 *  This is the preferred way to initialize an io_pin_t because it ensures that
 *  all the nessesary values will be in place.
 *
 *  @param port Pointer to the physical xMega port the pin is on.
 *  @param pin Pin on the given port. (Pin is zero indexed)
 *  @return Returns a io_pin_t struct that can be used to reference the given pin.
 */
io_pin_t  io_init_pin(PORT_t *port, uint8_t pin);

/** @brief Sets the direction of a DIO pin.
 *
 *  This function which sets the direciton of an xMega IO pin. The direction of
 *  all pins should be set before use. By default all pins are inputs, but to be
 *  safe, it is good practice to always set the direction.
 *
 *  @param pin The io_pin_t struct for the pin being configured.
 *  @param direction Direction that the pin should be set to.
 */
void io_set_direction(io_pin_t pin, io_pin_direction_t direction);

/** @brief Sets the digital output level of a pin.
 *
 *  This function sets the output level of a digital IO pin. The pin must
 *  already be configured as an output.
 *
 *  @param pin io_pin_t for the pin to be set.
 *  @param level Logic level to set the pin to.
 */
void io_set_output(io_pin_t pin, io_pin_level_t level);

/** @brief Toggles a DIO output
 *
 *  This function toggles an IO pin from high to low, or low to high. This
 *  function only works if the pin has already been configured as an output.
 *
 *  @param pin io_pin_t of the pin to be toggled.
 */
void io_toggle_output(io_pin_t pin);

/** @brief Gets the logic level of a DIO pin
 *
 *  This function gets the logic level of any DIO pin. If the pin is configured
 *  as in input, it's the current logic level. If the pin is an output then this
 *  returns the output level of the pin.
 *
 *  @param pin The io_pin_t of the pin to be read.
 *  @return Logic level of the pin.
 */
io_pin_level_t io_get_input(io_pin_t pin);

/** @brief Enables the pullup resistor on a pin.
 *  
 *  This function enables the internal 20 KOhm pullup resistors on any of the
 *  xMega DIO pins. The pin must be set as an input for the pullup to have an
 *  effect.
 *
 *  @param pin io_pin_t of pin which to enable pullup on.
 */
void io_pin_enable_pullup(io_pin_t pin);

/** @brief Disables the pullup resistor on a pin.
 *  
 *  This function disables the internal 20 KOhm pullup resistors on any of the
 *  xMega DIO pins. The pin must be set as in input for this to have an effect.
 *
 *  @param pin io_pin_t of pin to disable the pullup of.
 */
void io_pin_disable_pullup(io_pin_t pin);

#endif // IO_PIN_H
