alireza1405/medulla/firmware/medulla_lib/include/ad7193.h

#ifndef AD7193_ADC_H
#define AD7193_ADC_H

/** @file
 *  @brief Driver for controlling the AD7193 SPI ADC using one of the usart ports 
 *  on the xmega.
 *
 *  Driver for controlling the AD7193 SPI ADC using one of the usart ports on the 
 *  xmega. Currently the driver only supports reading a single usart at a time since
 *  this is the only way only way to achieve 1Khz update speed.
 */

#include <avr/io.h>
#include <avr/interrupt.h>
#include <util/delay.h>
#include <stdbool.h>
#include <string.h>

typedef struct {
	PORT_t *usart_port;
	USART_t *usart_reg;
	int16_t *destination;
	volatile bool currently_reading;
} ad7193_t;

typedef struct {
	ad7193_t *adc_pntr;
	volatile uint8_t buffer_position;
	uint8_t buffer[4];
} _ad7193_buffer_t;

_ad7193_buffer_t _ad7193_USARTC0,
                 _ad7193_USARTC1,
                 _ad7193_USARTD0,
                 _ad7193_USARTD1,
                 _ad7193_USARTE0,
                 _ad7193_USARTE1,
                 _ad7193_USARTF0,
                 _ad7193_USARTF1;

#define AD7193_USES_PORT(USART_PORT) \
ISR(USART_PORT##_TXC_vect) { /* TX complete interrupt used for sending configuration */ \
	if (_ad7193_##USART_PORT.buffer_position < 4) { \
		USART_PORT.DATA = _ad7193_##USART_PORT.buffer[_ad7193_##USART_PORT.buffer_position]; \
		_ad7193_##USART_PORT.buffer_position += 1; \
	} \
	else \
		_ad7193_##USART_PORT.adc_pntr->currently_reading = false; \
}\
\
ISR(USART_PORT##_RXC_vect) { /* RX complete interrupt used for reading ADC data */ \
	if (_ad7193_##USART_PORT.buffer_position > 0) \
		_ad7193_##USART_PORT.buffer[4 - _ad7193_##USART_PORT.buffer_position] = USART_PORT.DATA; \
	\
	if (_ad7193_##USART_PORT.buffer_position < 3) \
		USARTF0.DATA = 0; \
	else \
		_ad7193_##USART_PORT.adc_pntr->currently_reading = false; \
	\
	_ad7193_##USART_PORT.buffer_position += 1;  \
}

ad7193_t ad7193_init(PORT_t *usart_port, USART_t *usart_reg, int16_t *destination);

/** @brief Starts clocking in data from the ADC
 *
 * 	This function begins clocking in a word of data from the ADC. Note that if 
 * 	the ADC finishes a conversion while data is being clocked out, all the data
 * 	clocked out after that time will be from the new sample. This may cause data
 * 	corruption.
 * 	TODO: Consider implementing a synchronization method. 
 *
 *  @param adc Pointer to the ad7193_t struct to start reading.
 *  @return true - Successfully started clocking in data.
 *  @return false - Failed to start reading data because USART already active.
 */
bool ad7193_start_read(ad7193_t *usart_adc);

bool ad7193_read_complete(ad7193_t *usart_adc);

void ad7193_process_data(ad7193_t *usart_adc);

#endif //AD7193_H
