alireza1405/medulla/software/sii_tool/eepromtype.h

#ifndef EEPROMTYPE_H
#define EEPROMTYPE_H

#include <vector>
#include <stdint.h>
#include <QtXml>
#include <QDebug>
#include <QByteArray>

class eepromType
{
public:
    eepromType(QDomElement element, bool verbose);

    uint16_t size; // Size of eeprom in bytes
    QByteArray configData; // Configuration data
    QByteArray bootStrap; // Bootstrap mailbox section data
    QByteArray eepromData; // Full eeprom data stored here if it's in the ESI file.
    QByteArray siiData;
    bool definedData;

private:
    bool verb;
};

#endif // EEPROMTYPE_H
