alireza1405/medulla/software/sii_tool/entrytype.h

#ifndef ENTRYTYPE_H
#define ENTRYTYPE_H

#include <QtXml>
#include <stdint.h>

class EntryType
{
public:
    EntryType(QDomElement element, bool verbose);

    uint16_t index;
    uint8_t subIndex;
    QString name;
    uint8_t typeIndex; // Index of type in COE dictionary
    uint8_t bitLen;

private:
    bool verb;
};

#endif // ENTRYTYPE_H
