alireza1405/medulla/(commit log)

2011-09-05 added medulla.0 design files and an image of 1.5
    [BOM-medulla.0.ods, ET1100_configuration_and_pinout_V4.1.xls, medulla.0.pcb, medulla.0.sch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]
2011-09-05 added 1.0
    [BOM-medulla.1.ods, medulla.1.pcb, medulla.1.sch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]
2011-09-05 added some 1.5 firmeware. It needs to be cleaned up to be more generic.
    [BOM-medulla.1.5.ods, medulla.1.5.pcb, medulla.1.5.sch]
2012-06-28 Implemented SPI driver (tested, seems to work, but needs more testing. Tested an fixed bugs in io pin library.
    [ethercat.h, io_pin.c, io_pin.h, spi.c, spi.h]
2012-06-28 improved the spi driver
2012-07-03 Added fully buffered interrupt driven uart driver
2012-07-03 Added features to uart driver to make it really easy to use printf with a uart port
2012-07-06 Merging changes from the ATRIAS subversion. This fixes the SPI and uart drivers so they work. Adds an ethercat driver. The clock driver has been replaced by cpu.h/.c which provides clock control as w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
    [cpu.c, cpu.h, ethercat.c, ethercat.h, medulla_lib_test.c, spi.c, spi.h, uart.c]
2012-07-13 Fixed EtherCAT driver, added PWM, limit switch, and E-Stop driver
    [estop.c, estop.h, ethercat.c, limit_switch.c, limit_switch.h, medulla_lib_test.c, pwm.c, pwm.h]
2012-07-24 This is a major update from the last commit. I added a whole bunch of new drivers, and for now the library is complete as it contains all the drivers we need for ATRIAS. The has been a couple of majo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
2012-07-24 I forgot to commit this directory as well. This is a test program which includes numerous tests for the different drivers
2012-07-24 This file is no longer needed as it has been moved into the medulla_lib_test directory
    [medulla_lib_test.c]
2012-07-24 Chaned uart driver to use 16 bit ints for storing the buffer lengths and positions.
2012-07-26 Changes the implementation of the uart commit so it is much faster to transmit large buffers of data.
2012-07-26 DZRALTE comm driver now assembles the packet into a single buffer before transmitting to reduce transmission time.
2012-07-26 Fixed bug in limit switch. Fixed strange corner case in uart.c which would cause uart output to freeze
    [limit_switch.c, uart.c]
2012-07-28 Fixed bug in dzralte driver which cause the data CRC to be sent out incorrectly. Made the biss-c driver a litte faster
    [biss_encoder.c, dzralte_comm.c]
2012-07-30 Tried to make spi faster, succeeded partially.
2012-08-03 Fixed the ssi encoder driver for the 17 bit hengstler encoder, split the ssi driver so that seperate drivers can be used for seperate types of encoders. Added experemental driver for usart adc.
    [hengstler_ssi_encoder.c, hengstler_ssi_encoder.h, limit_switch.c, medulla_lib_test.c, renishaw_ssi_encoder.c, renishaw_ssi_encoder.h, spi.h, usart_adc.h]
2012-08-04 Finished splitting renishaw and hengstler ssi encoders into seperate drivers.
2012-08-09 Fixed bug that caused pwm outputs from timer counter 1 on any port to not disable when the disable function was called.
    [pwm.c]
2012-08-09 Adding ethercat ESC files and ethercat test programs
2012-08-14 Fixed bug in biss encoder driver caused by previous changes to spi driver. Increased the timeout on changing CPU frequencies. A little more work on the usart ADC driver.
    [biss_encoder.c, cpu.c, medulla_lib_test.c, usart_adc.h]
2012-08-31 Fixed bug in spi driver that sometimes can cause a deadlock issue when transmitting a single byte over spi.
    [spi.c]
2012-09-04 Finally fixed the usart adc driver. It should now be fully functional.
    [medulla_lib_test.c, usart_adc.h]
2012-09-06 Added basic imu drivers for 3DM-GX3-25, should be commeneted more explicitly
2012-09-07 Added imu drivers to medulla_lib, now functional with generally accepted UART
2012-09-07 Modified imu drivers to have a stable current data buffer
2012-09-11 Fixed IMU driver. You really need to use include protection.
2012-09-14 Fixed bug in PWM that caused glitching of the output signal.
    [pwm.c, pwm.h]
2012-09-14 Fixed bug in renishaw sii encoder driver.
    [medulla_lib_test.c, renishaw_ssi_encoder.c]
2012-09-14 One more fix for the renishaw encoder driver.
    [renishaw_ssi_encoder.c]
2012-09-16 Fixing the PWM driver for a second time.
    [pwm.c]
2012-09-18 Fixing bug in usart ADC driver.
    [medulla_lib_test.c, usart_adc.h]
2012-09-19 Modified process Orientation data in imu.c to only put the proper 64 bytes into the ethercat buffer
2013-01-23 Fixed typo in comment.
    [uart.c]
2013-03-20 Fixed bug in ehtercat.c which cuased long addressing to be used for memory addresses that did not require it.
    [ethercat.c]
2013-03-28 Finished basic test for new strain gauge ADC.
2013-04-01 more testing of the new ADC board.
2013-05-06 Renamed usart_adc driver to adc124 since I will be adding another usart ADC driver.
2013-05-06 Forgot to rename some things in adc124.h. Added files for ad7193 adc.
2013-05-06 Implemented interrupt for ad7193 adc driver.
2013-05-08 Finished writing ad7193 adc driver, now it needs to be tested.
2013-05-10 Implemented testing code for ad7193 driver.
2013-05-12 Corrected sii_file.h. Addresses were word addressed, now they are byte addressed since we are using a byte array.
    [sii_file.h, sii_tool.cpp]
2013-05-12 Turns out that specification mixes word and byte addressing in it's tables, fixed sii_file.h header to correct for this.
    [sii_file.h]
2013-05-12 I has parsing the device groups incorrectly, fixed now. Also improved verbose debug messages.
    [dctype.cpp, devicetype.cpp, devicetype.h, eepromtype.cpp, entrytype.cpp, fmmutype.cpp, grouptype.cpp, grouptype.h]
2013-05-13 Fixed some bugs and it now generates more of the sii file.
    [devicetype.cpp, devicetype.h, fmmutype.h, sii_file.h, sii_tool.cpp, sii_tool.h]
2013-05-22 AD7193 ADC driver is now working.
2013-05-23 Estop driver now checks if the estop has been enabled when checking if estop event has occurred.
2013-05-28 Adjusted uart baud rate values. Temprary fix to estop code that keeps it from mashing on PORTF1.
    [estop.c, uart.h]
2013-05-28 I tried to fix the trouble with io_pin driver, it may or may not have worked.
    [io_pin.c]
2013-05-28 Fixed bugs in ad7193 driver, it now works when integrated into medulla code.
    [ad7193.c]
2013-05-29 Convert adc value into actual signed number.
2013-05-30 Fixed deassert estop function, I broke it trying to make it not stop on other register.
    [estop.c, io_pin.h]
2013-06-12 Fixed errors in medulla board layout. Now new boards won't need to have bodge wires or cut traces.
    [medulla.1.5.pcb]
2013-06-18 adc124 driver no longer uses the io_port functions, they may have been interfering with the encoders.
    [adc124.c]
2013-06-19 Tried adjusted ad7193 driver to use software spi.
2013-07-10 adding zip used to order the last batch of boards
2013-09-01 Changed debugging UART to low-level interrupt
    Since this port is only used for debugging, this shouldn't affect any part of
    normal operation.
    - Marshal
2013-09-01 Fixed initialization for adc124
    The strain gauge readers should now work!
    The problem was an unknown frame offset due to not having control of the
    Chip Select pin. So, the frame offset is calibrated off channel 4, which
    should always have a pull-up resistor and never be connected to a sensor.
    If this has to change, there are other ways we can do this, but they require
    changes in the hardware interface.
    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
    [adc124.c, adc124.h]
2013-11-04 The IMU driver files in here are very outdated, so I am removing them.
2013-11-04 Reverting changes to adc124 driver because they are not needed.
    [adc124.c, adc124.h]
2013-11-18 Added extracted CAM files to repository.
    [Drill.drl]
2013-11-18 Corrected silkscreen on port F of medulla.
    [medulla.1.5.pcb]
2013-11-19 Generated CAM files for fixed medulla board.
    [Drill.drl]
2013-11-20 Fixed errors found in Advanced Circuits DFM test.
    [medulla.1.5.pcb]
2013-11-20 Added script to generate Component Placement List for manufacturing. Still need to check that all component pin numbers and orientations match the standard.
2013-11-22 Added CPL file, BOM, and paste mask files to CAM directory.
    [BOM.xls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]
2014-04-08 Implemented Round Robin Interrupt Scheduling enable function
2014-04-08 Fixed bugs in last commit.
    [cpu.c]
2014-05-06 Switch UART 921600 baudrate BSEL back to 0x96.
    Use with external crystal oscillator.
    [uart.h]
2014-12-01 ADC SPI clock slowed to 1 MHz to fix communication issues.
    [adc124.c]
2015-01-14 Analog comparator and DAC drivers implemented.
2015-01-15 Comparator driver updated to use voltage scaler.
2015-01-15 Added new paramater to ac_init_port in ac.h which prevented compiling.
    [ac.h]
